whowechina/aic_pico/doc/aic_touch_pcb.png

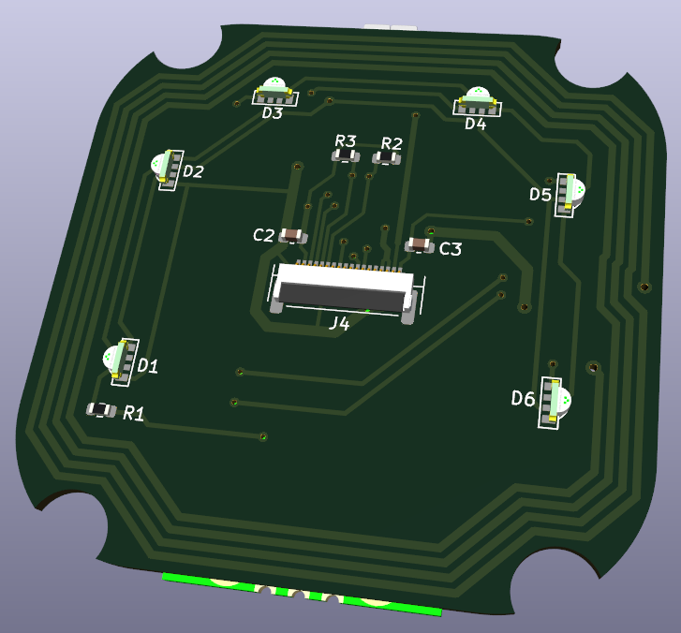
doc/aic_touch_pcb.png
