whowechina/aic_pico/res/aime_reader.png

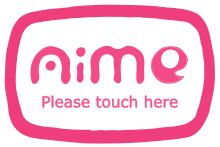
res/aime_reader.png
