whowechina/aic_pico/res/bana_reader.png

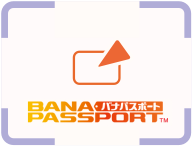
res/bana_reader.png
