whowechina/aic_pico/res/cards/aic_bana.png

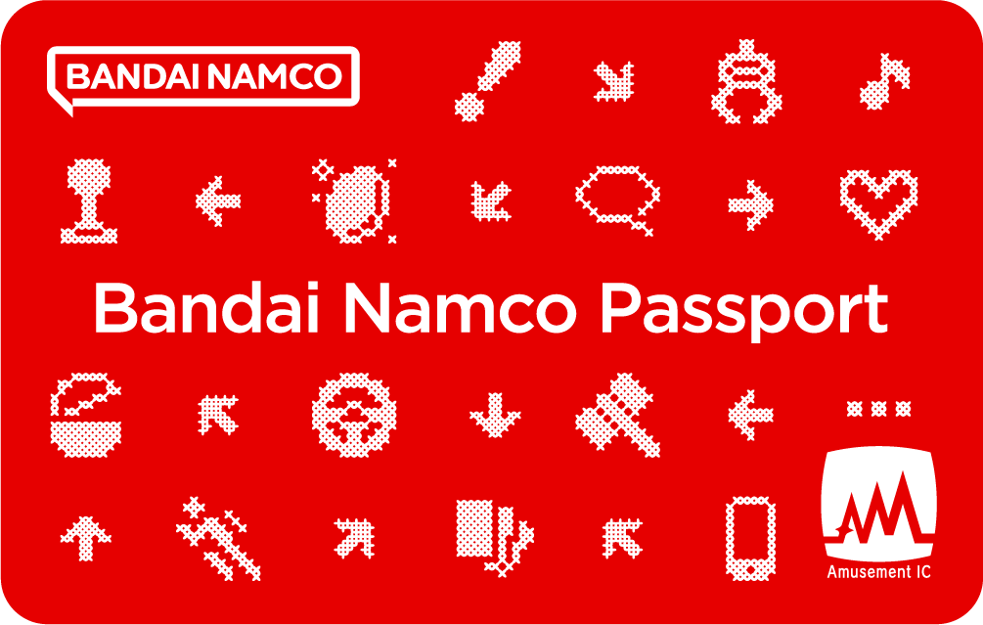
res/cards/aic_bana.png
