whowechina/aic_pico/res/cards/aic_bana_yellow.png

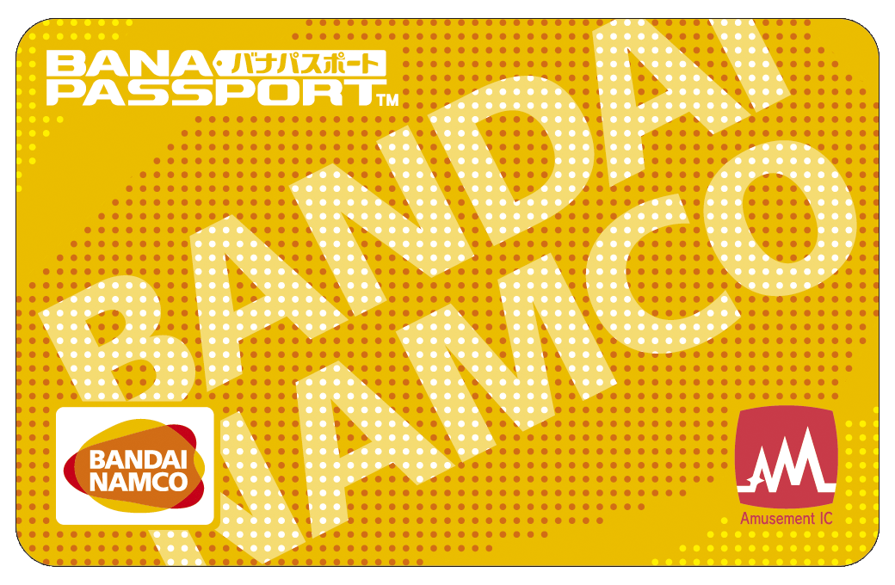
res/cards/aic_bana_yellow.png
