whowechina/aic_pico/res/cards/aic_generic.png

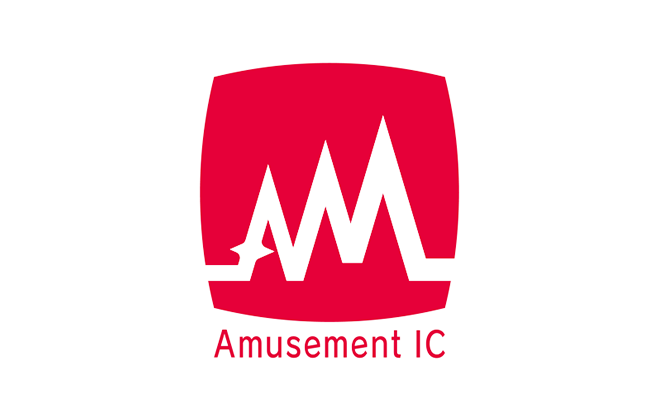
res/cards/aic_generic.png
