whowechina/aic_pico/res/cards/aic_generic_130.png

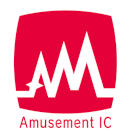
res/cards/aic_generic_130.png
