whowechina/aic_pico/res/cards/aic_konami.png

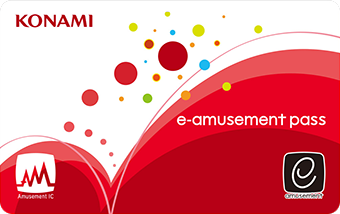
res/cards/aic_konami.png
