whowechina/aic_pico/res/cards/aic_nesica.png

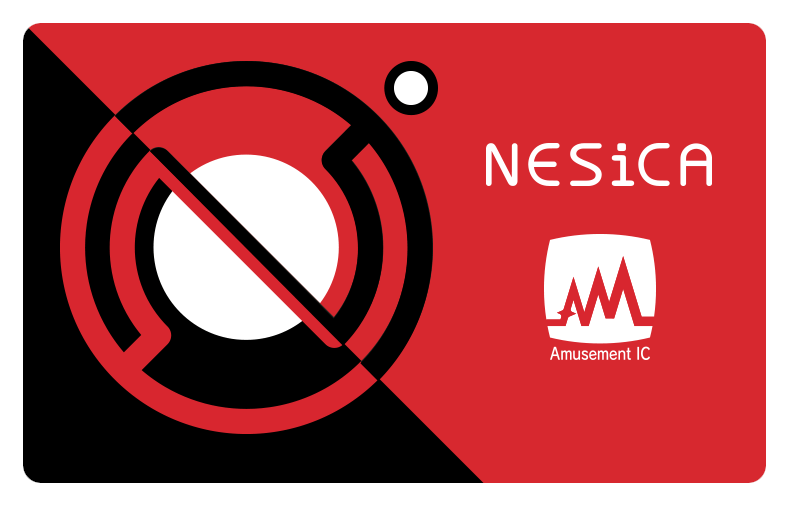
res/cards/aic_nesica.png
