whowechina/aic_pico/res/cards/aic_sega.png

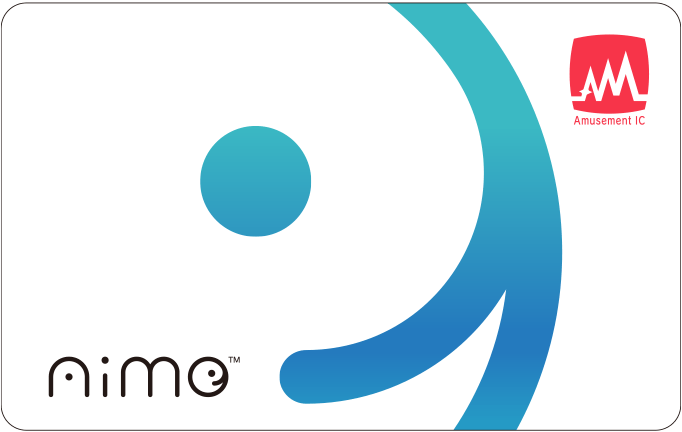
res/cards/aic_sega.png
