whowechina/aic_pico/res/cards/aic_sega_220.png

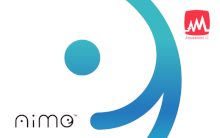
res/cards/aic_sega_220.png
