whowechina/aic_pico/res/cards/Aime20122018CardDesign.webp

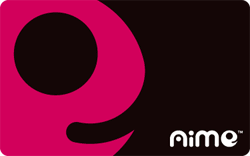
res/cards/Aime20122018CardDesign.webp
