whowechina/aic_pico/res/cards/bana_220.png

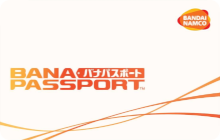
res/cards/bana_220.png
