whowechina/aic_pico/res/cards/bana_white.png

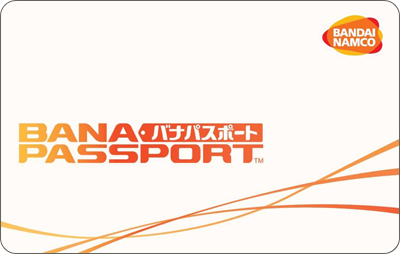
res/cards/bana_white.png
