whowechina/aic_pico/res/cards/eamuse.png

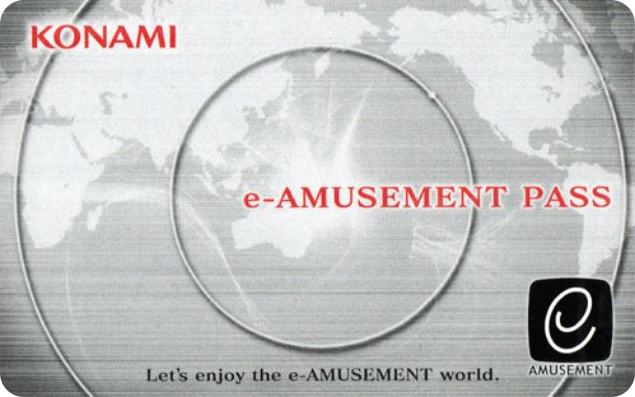
res/cards/eamuse.png
