whowechina/aic_pico/res/cards/nesica.png

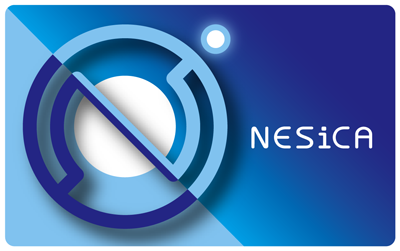
res/cards/nesica.png
