whowechina/aic_pico/res/cards/suica_220.png

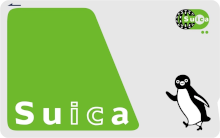
res/cards/suica_220.png
