whowechina/aic_pico/res/cards/vicinity_220.png

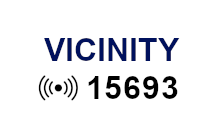
res/cards/vicinity_220.png
