whowechina/aic_pico/res/lightning.gif

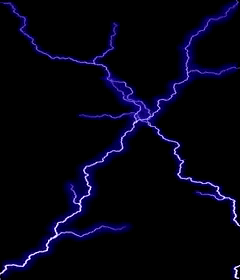
res/lightning.gif
