whowechina/aic_pico/Production/3DPrint/aic_touch_top_ams.3mf

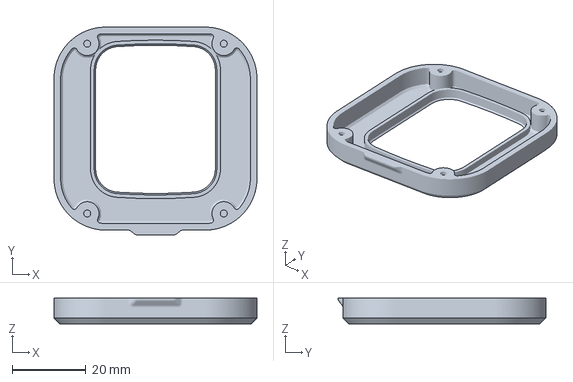
[picture p56: CAD file, 2024-10-22]
Production/3DPrint/aic_touch_top_ams.3mf
55.0 x 56.3 x 7.00 mm
