whowechina/aic_pico/Production/3DPrint/aic_touch_top.3mf

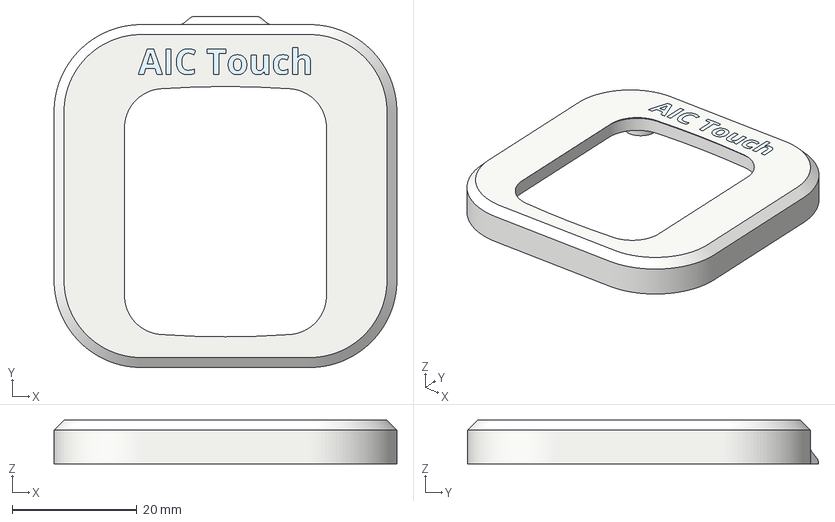
[picture p57: CAD file, 2024-06-03]
Production/3DPrint/aic_touch_top.3mf
55.0 x 56.3 x 7.00 mm
Top
Logo_A
Logo_I
Logo_C
Logo_T
Logo_o
Logo_u
Logo_c
Logo_h
