whowechina/aic_pico/Production/3DPrint/aic_key_top_nokey_ams.3mf

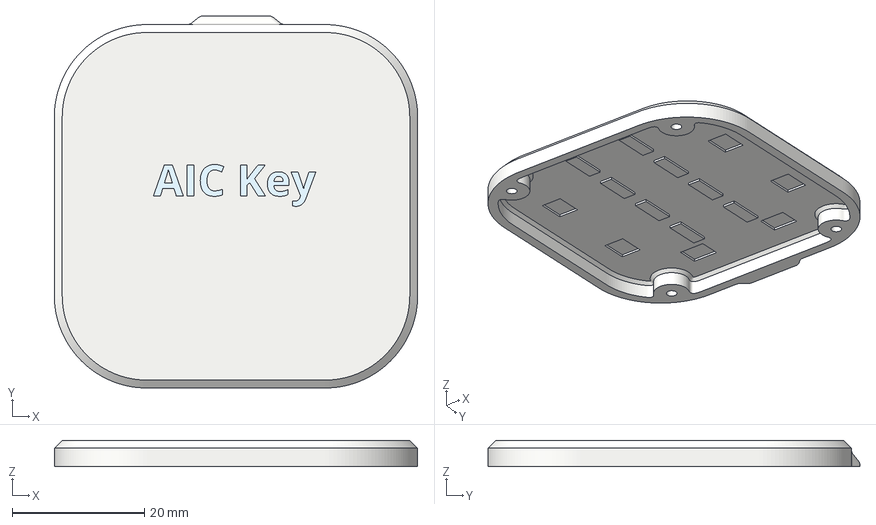
[picture p58: CAD file, 2024-03-24]
Production/3DPrint/aic_key_top_nokey_ams.3mf
55.0 x 56.3 x 4.00 mm
Logo_A
Top
Logo_I
Logo_C
Logo_K
Logo_e
Logo_y
