whowechina/aic_pico/Production/3DPrint/aic_key_top_nokey.stl

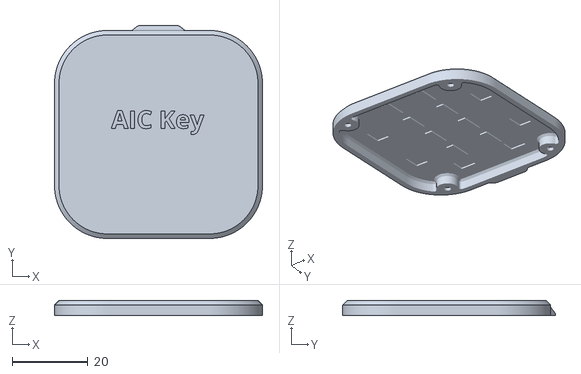
[picture p59: CAD file, 2024-03-24]
Production/3DPrint/aic_key_top_nokey.stl
55.0 x 56.3 x 4.00
