whowechina/aic_pico/Production/3DPrint/aic_key_top_surface_ams.3mf

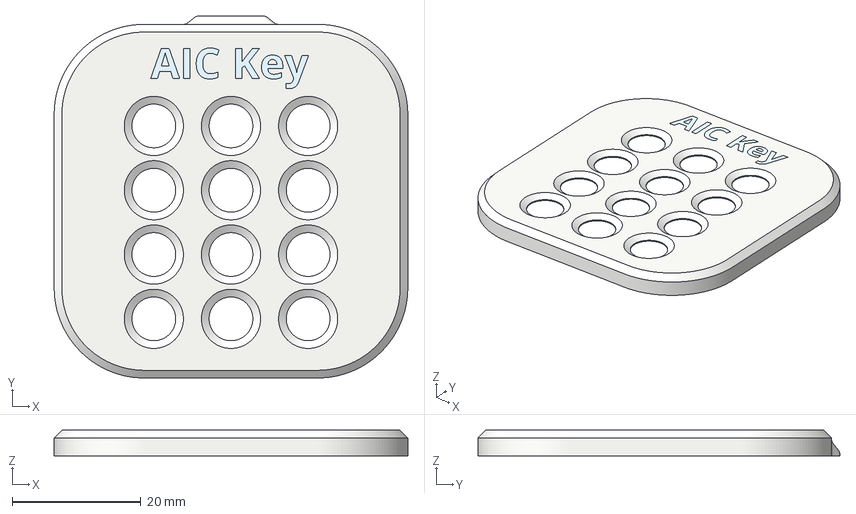
[picture p60: CAD file, 2024-02-25]
Production/3DPrint/aic_key_top_surface_ams.3mf
55.0 x 56.3 x 4.00 mm
Logo_K
Top
Logo_A
Logo_I
Logo_C
Logo_e
Logo_y
