whowechina/aic_pico/Production/3DPrint/aic_pico_top.stl.stl

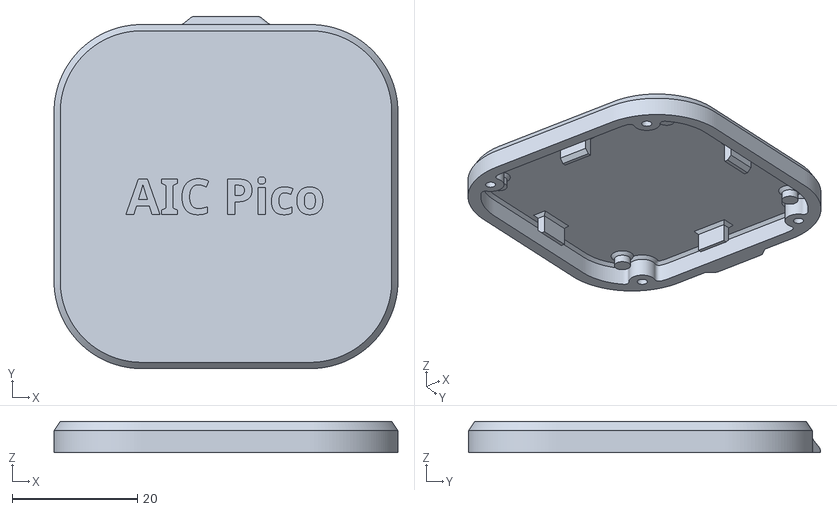
[picture p61: CAD file, 2024-02-25]
Production/3DPrint/aic_pico_top.stl.stl
55.0 x 56.3 x 5.00
