whowechina/aic_pico/Production/3DPrint/aic_pico_top_ams.3mf

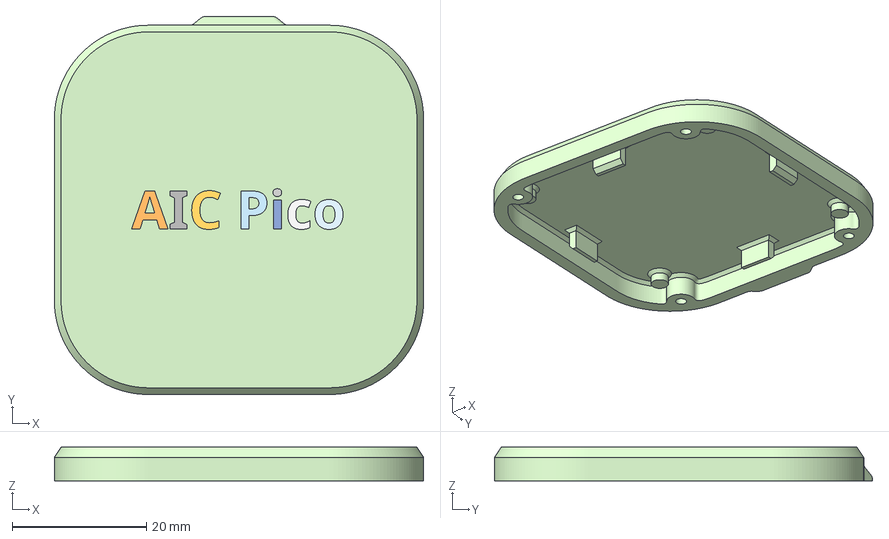
[picture p62: CAD file, 2024-02-25]
Production/3DPrint/aic_pico_top_ams.3mf
55.0 x 56.3 x 5.00 mm
Logo_2
Top
Logo_1
Logo_3
Logo_4
Logo_5
Logo_6
Logo_7
Logo_8
