whowechina/aic_pico/Production/3DPrint/aic_touch_bottom.stl

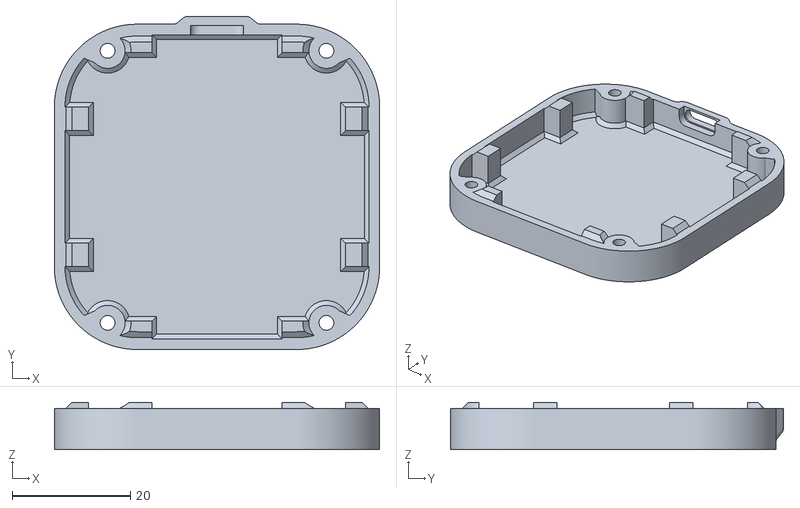
[picture p63: CAD file, 2024-02-25]
Production/3DPrint/aic_touch_bottom.stl
55.0 x 56.3 x 8.00
