whowechina/aic_pico/Production/3DPrint/aic_key_top_tact_ams.3mf

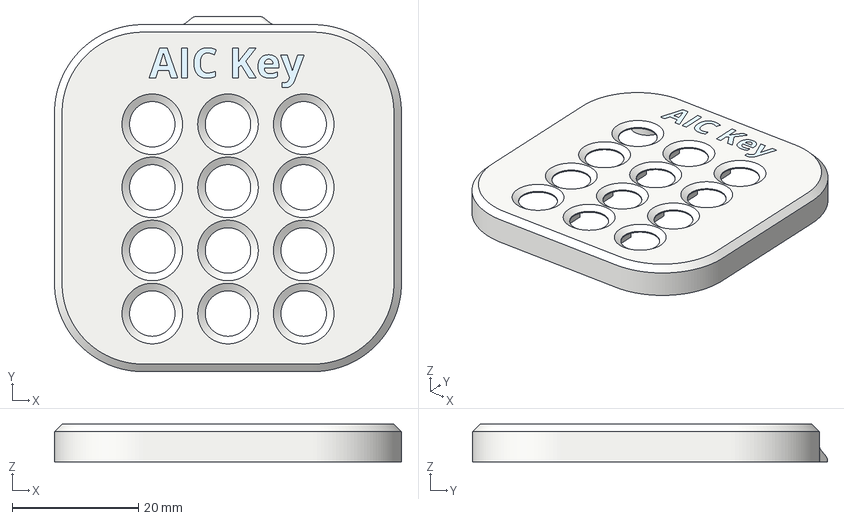
[picture p64: CAD file, 2024-02-25]
Production/3DPrint/aic_key_top_tact_ams.3mf
55.0 x 56.3 x 6.00 mm
Logo_y
Top
Logo_A
Logo_I
Logo_C
Logo_K
Logo_e
