whowechina/aic_pico/Production/3DPrint/aic_key_top_tact.stl

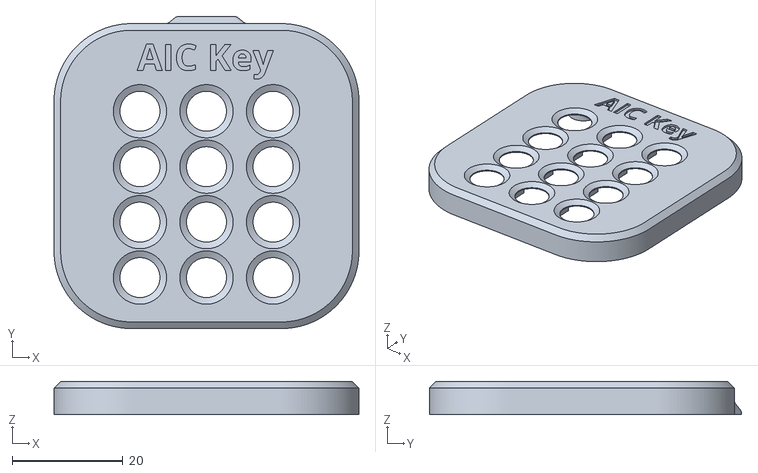
[picture p65: CAD file, 2024-02-25]
Production/3DPrint/aic_key_top_tact.stl
55.0 x 56.3 x 6.00
