whowechina/aic_pico/Production/3DPrint/aic_key_top_surface.stl

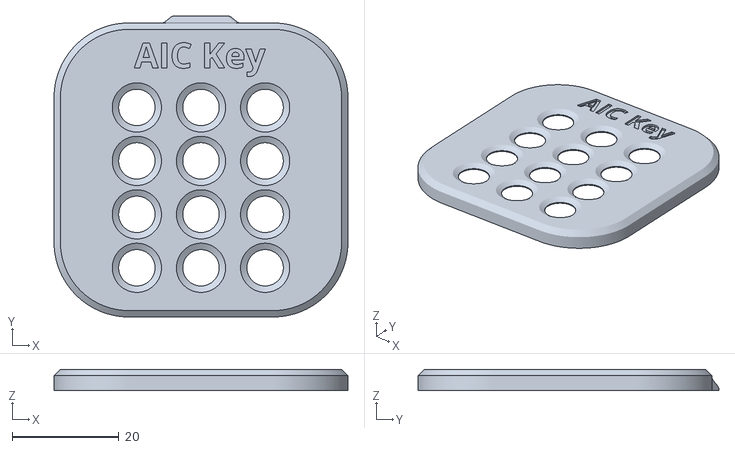
[picture p66: CAD file, 2024-02-25]
Production/3DPrint/aic_key_top_surface.stl
55.0 x 56.3 x 4.00
