whowechina/aic_pico/Production/3DPrint/aic_pico_top_tall.stl

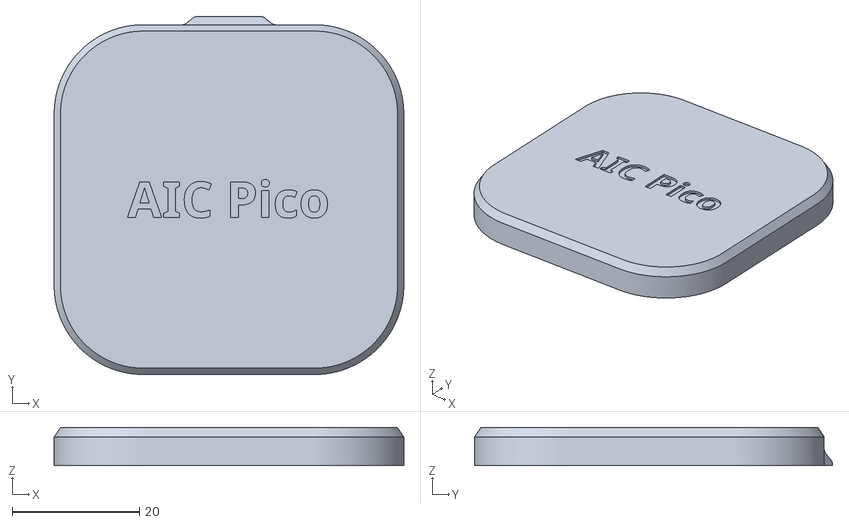
[picture p67: CAD file, 2024-02-25]
Production/3DPrint/aic_pico_top_tall.stl
55.0 x 56.3 x 6.00
