whowechina/aic_pico/Production/3DPrint/aic_pico_top_tall_ams.3mf

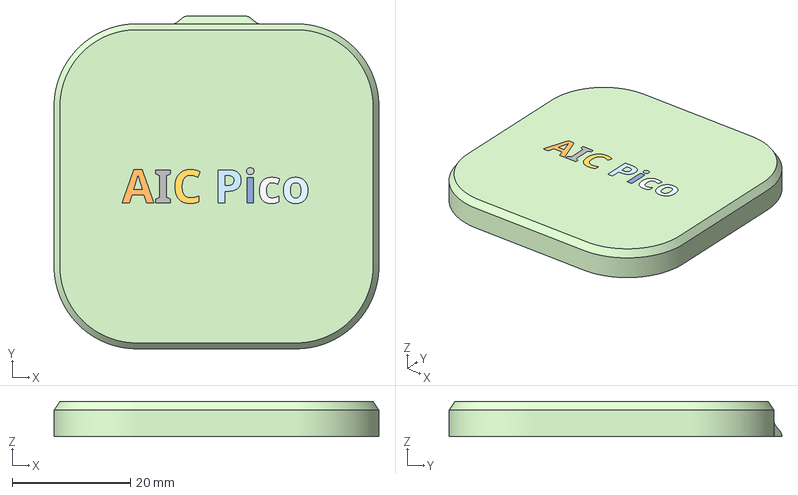
[picture p68: CAD file, 2024-02-25]
Production/3DPrint/aic_pico_top_tall_ams.3mf
55.0 x 56.3 x 6.00 mm
Logo_3
Top
Logo_1
Logo_2
Logo_4
Logo_5
Logo_6
Logo_7
Logo_8
