whowechina/aic_pico/Production/3DPrint/aic_pico_bottom.stl

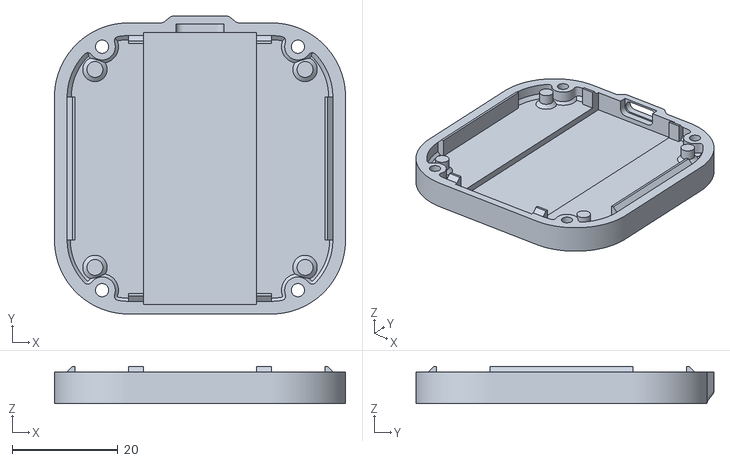
[picture p69: CAD file, 2024-02-25]
Production/3DPrint/aic_pico_bottom.stl
55.0 x 56.3 x 7.00
