whowechina/aic_pico/(list of files, cad)

Other CAD files:
Production/3DPrint/aic_touch_top.stl
