whowechina/aic_pico/(threads)

Thread 4 (2025-02-04):

AIC Pico Auto mode doesn't work on some games

Ragnar-es, 2025-02-04:
AIC Pico Auto mode doesn't work on some games like Sega World Drivers Championship and Fate Grand Order Arcade. Manually setting aime1 mode is needed everytime those games are played.

This is the debug output for SWDC on "Auto" mode, from when I launch the game until I get the 6506 error (which is aime reader error).

[auto_fail.txt](https://github.com/user-attachments/files/18659149/auto_fail.txt)

This is the debug output for SWDC on "Aime1" mode, from when I launch the game to when the reader gets lighted up ready to read cards.

[aime1_success.txt](https://github.com/user-attachments/files/18659150/aime1_success.txt)

whowechina, 2025-03-07:
So far, I have no way to tell the mode. I'll leave this open, until I find a solution or a complete dead-end.
