whowechina/aic_pico/(list of files, drawings)

Other design files:
doc/aic_pico_pn532.fzz
doc/aic_pico_pn5180.fzz
