whowechina/aic_pico/firmware/src/button_ani.h

#include "anima.h"

const uint8_t glow_data[] = {
    // frame 0
    0x00, 0x8d, 0x11, 0x10, 0x00, 0x03, 0x01, 0x00, 0x18, 0x11, 0x12, 0x22, 0x22, 0x11, 0x11, 0x12,
    0x22, 0x22, 0x11, 0x10, 0x00, 0x14, 0x11, 0x22, 0x33, 0x44, 0x44, 0x34, 0x55, 0x56, 0x67, 0x75,
    0x32, 0x21, 0x11, 0x00, 0x12, 0x01, 0x23, 0x67, 0x78, 0xaa, 0xda, 0x74, 0x22, 0x22, 0x22, 0x48,
    0xa6, 0x33, 0x21, 0x10, 0x00, 0x11, 0x14, 0x77, 0x77, 0xac, 0xda, 0x75, 0x31, 0x10, 0x11, 0x11,
    0x26, 0xba, 0xa6, 0x42, 0x21, 0x10, 0x00, 0x0f, 0x01, 0x55, 0x22, 0x23, 0x8a, 0x65, 0x42, 0x11,
    0x00, 0x01, 0x10, 0x01, 0x14, 0x8c, 0xda, 0x85, 0x32, 0x11, 0x00, 0x0e, 0x01, 0x26, 0x31, 0x11,
    0x12, 0x23, 0x32, 0x21, 0x00, 0x03, 0x01, 0x12, 0x35, 0x7c, 0xda, 0x84, 0x22, 0x11, 0x00, 0x0c,
    0x01, 0x12, 0x63, 0x10, 0x00, 0x01, 0x01, 0x12, 0x11, 0x00, 0x05, 0x12, 0x23, 0x35, 0x8d, 0xaa,
    0x53, 0x21, 0x10, 0x00, 0x0b, 0x12, 0x35, 0x51, 0x00, 0x02, 0x01, 0x11, 0x00, 0x07, 0x12, 0x33,
    0x47, 0xca, 0xa6, 0x32, 0x11, 0x00, 0x0a, 0x01, 0x26, 0xaa, 0x31, 0x00, 0x03, 0x01, 0x10, 0x00,
    0x06, 0x01, 0x22, 0x23, 0x6b, 0xbb, 0x63, 0x21, 0x10, 0x00, 0x09, 0x02, 0x67, 0x68, 0x32, 0x10,
    0x00, 0x02, 0x01, 0x10, 0x00, 0x07, 0x01, 0x22, 0x35, 0xbc, 0xc6, 0x32, 0x11, 0x00, 0x09, 0x14,
    0x53, 0x76, 0x22, 0x00, 0x0d, 0x12, 0x23, 0x6b, 0xda, 0x53, 0x21, 0x00, 0x09, 0x15, 0x22, 0x63,
    0x21, 0x00, 0x0d, 0x01, 0x22, 0x37, 0xcd, 0x84, 0x21, 0x10, 0x00, 0x07, 0x01, 0x25, 0x22, 0x11,
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
    0, 831, 1592, 2369, 3061, 3848, 4612, 5393, 6208, 7007, 7780, 8556, 9400, 10178, 10976, 11748, 12546, 13365, 14145, 14964, 15720,
};

const anima_t glow_ani = {
    .width = 64,
    .height = 64,
    .frames = 21,
    .index = glow_index,
    .data = glow_data,
};
