whowechina/aic_pico/firmware/src/conthrax.h

/*
 * Conthrax font by Typodermic Fonts Inc.
 * Downloaded from https://www.dafont.com/
 * Converted using https://lvgl.io/tools/fontconverter
 * Modificated for AIC Pico use
 */

#include <stdint.h>
#include "lvgl_font.h"

static const uint8_t conthrax_bitmap[] = {
    /* U+0030 "0" */
    0x0, 0x0, 0x0, 0x0, 0x15, 0x72, 0xad, 0xdb,
    0xed, 0xfb, 0xff, 0xff, 0xff, 0xff, 0xff, 0xff,
    0xff, 0xfb, 0xed, 0xdb, 0xae, 0x73, 0x16, 0x0,
    0x0, 0x0, 0x0, 0x0, 0x0, 0x1, 0x73, 0xf9,
    0xff, 0xff, 0xff, 0xff, 0xff, 0xff, 0xff, 0xff,
    0xff, 0xff, 0xff, 0xff, 0xff, 0xff, 0xff, 0xff,
    0xff, 0xf9, 0x77, 0x2, 0x0, 0x0, 0x0, 0x0,
    0x80, 0xff, 0xff, 0xff, 0xff, 0xff, 0xff, 0xff,
    0xff, 0xff, 0xff, 0xff, 0xff, 0xff, 0xff, 0xff,
    0xff, 0xff, 0xff, 0xff, 0xff, 0xff, 0x85, 0x0,
    0x0, 0x0, 0x29, 0xfd, 0xff, 0xff, 0xff, 0xff,
    0xff, 0xff, 0xff, 0xff, 0xff, 0xff, 0xff, 0xff,
    0xff, 0xff, 0xff, 0xff, 0xff, 0xff, 0xff, 0xff,
    0xff, 0xfe, 0x2e, 0x0, 0x0, 0x92, 0xff, 0xff,
    0xff, 0xff, 0xff, 0xbc, 0x7f, 0x64, 0x5b, 0x5b,
    0x5b, 0x5b, 0x5b, 0x5b, 0x5b, 0x64, 0x7f, 0xba,
    0xff, 0xff, 0xff, 0xff, 0xff, 0x98, 0x0, 0x0,
    0xd2, 0xff, 0xff, 0xff, 0xff, 0x6d, 0x0, 0x0,
    0x0, 0x0, 0x0, 0x0, 0x0, 0x0, 0x0, 0x0,
    0x0, 0x0, 0x0, 0x68, 0xff, 0xff, 0xff, 0xff,
    0xd8, 0x0, 0x5, 0xfc, 0xff, 0xff, 0xff, 0xe2,
    0x4, 0x0, 0x0, 0x0, 0x0, 0x0, 0x0, 0x0,
    0x0, 0x0, 0x0, 0x0, 0x0, 0x0, 0x2, 0xdd,
    0xff, 0xff, 0xff, 0xfe, 0xa, 0x14, 0xff, 0xff,
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
    0x93, 0xff, 0xff, 0xff, 0xff, 0xff, 0xff, 0x23,
    0x93, 0xff, 0xff, 0xff, 0xff, 0xff, 0xff, 0x23,
    0x93, 0xff, 0xff, 0xff, 0xff, 0xff, 0xff, 0x23,
    0x93, 0xff, 0xff, 0xff, 0xff, 0xff, 0xff, 0x23,
    0x93, 0xff, 0xff, 0xff, 0xff, 0xff, 0xff, 0x23
};

static const lv_font_dsc_t conthrax_dsc[] = {
    {.bitmap_index = 0, .adv_w = 464, .box_w = 27, .box_h = 23, .ofs_x = 1, .ofs_y = 0},
    {.bitmap_index = 621, .adv_w = 173, .box_w = 9, .box_h = 23, .ofs_x = 9, .ofs_y = 0},
    {.bitmap_index = 828, .adv_w = 442, .box_w = 25, .box_h = 23, .ofs_x = 1, .ofs_y = 0},
    {.bitmap_index = 1403, .adv_w = 432, .box_w = 25, .box_h = 23, .ofs_x = 1, .ofs_y = 0},
    {.bitmap_index = 1978, .adv_w = 463, .box_w = 28, .box_h = 23, .ofs_x = 1, .ofs_y = 0},
    {.bitmap_index = 2622, .adv_w = 442, .box_w = 25, .box_h = 23, .ofs_x = 1, .ofs_y = 0},
    {.bitmap_index = 3197, .adv_w = 444, .box_w = 25, .box_h = 23, .ofs_x = 1, .ofs_y = 0},
    {.bitmap_index = 3772, .adv_w = 424, .box_w = 26, .box_h = 23, .ofs_x = 0, .ofs_y = 0},
    {.bitmap_index = 4370, .adv_w = 463, .box_w = 27, .box_h = 23, .ofs_x = 1, .ofs_y = 0},
    {.bitmap_index = 4991, .adv_w = 444, .box_w = 25, .box_h = 23, .ofs_x = 1, .ofs_y = 0},
    {.bitmap_index = 5566, .adv_w = 286, .box_w = 32, .box_h = 23, .ofs_x = -2, .ofs_y = 0},
    {.bitmap_index = 6302, .adv_w = 217, .box_w = 8, .box_h = 7, .ofs_x = 8, .ofs_y = 6}
};

static const lv_font_t lv_conthrax = {
    .range_start = 48,
    .range_length = 12,
    .bit_per_pixel = 8,
    .line_height = 23,
    .base_line = 0,
    .dsc = conthrax_dsc,
    .bitmap = conthrax_bitmap,
};
