whowechina/aic_pico/firmware/src/ltsaeada.h

/*
 * LT Saeada font by LyonsType
 * Downloaded from https://www.dafont.com/
 * Converted using https://lvgl.io/tools/fontconverter
 * Modificated for AIC Pico use
 */

#include <stdint.h>
#include "lvgl_font.h"

static const uint8_t lts13_bitmap[] = {
    /* U+0020 " " */

    /* U+0021 "!" */
    0x4d, 0x7, 0xf2, 0x6f, 0x16, 0xf0, 0x5f, 0x4,
    0xf0, 0x3d, 0x3, 0xa0, 0x5e, 0x10,

    /* U+0022 "\"" */
    0x4c, 0x3d, 0x6, 0xe4, 0xf0, 0x6e, 0x4f, 0x1,
    0x30, 0x40,

    /* U+0023 "#" */
    0x0, 0x79, 0x8, 0x70, 0x0, 0xc7, 0xe, 0x50,
    0x3f, 0xff, 0xff, 0xf4, 0x5, 0xf4, 0x7f, 0x30,
    0x4, 0xf0, 0x6d, 0x0, 0xaf, 0xff, 0xff, 0xd0,
    0x1b, 0xb3, 0xc9, 0x20, 0xc, 0x70, 0xd5, 0x0,
    0xc, 0x30, 0xd2, 0x0,

    /* U+0024 "$" */
    0x0, 0x0, 0x0, 0x0, 0x0, 0x0, 0x80, 0x0,
    0x0, 0x2, 0x80, 0x0, 0x4, 0xcf, 0xe9, 0x20,
    0x2f, 0xca, 0xbd, 0xa0, 0x5f, 0x26, 0x40, 0x0,
    0x2f, 0xba, 0x30, 0x0, 0x3, 0xaf, 0xf9, 0x20,
    0x0, 0xa, 0x5d, 0xd0, 0x22, 0xb, 0x6, 0xf0,
    0x7f, 0xbd, 0x8e, 0xc0, 0x6, 0xcf, 0xea, 0x10,
    0x0, 0x19, 0x0, 0x0, 0x0, 0x2, 0x0, 0x0,

    /* U+0025 "%" */
    0x1b, 0xfb, 0x10, 0x6, 0xa0, 0x8, 0xa1, 0xa8,
    0x3, 0xf4, 0x0, 0x79, 0x9, 0x70, 0xd8, 0x0,
    0x1, 0xbe, 0xb0, 0xac, 0x0, 0x0, 0x0, 0x0,
    0x6f, 0x4c, 0xd6, 0x0, 0x0, 0x2f, 0x5b, 0x61,
    0xe1, 0x0, 0xd, 0xa0, 0xd1, 0xb, 0x40, 0x9,
    0xd0, 0xb, 0x73, 0xe2, 0x0, 0xe3, 0x0, 0x2d,
    0xe7, 0x0,

    /* U+0026 "&" */
    0x6, 0xdf, 0xe9, 0x10, 0x3f, 0xb6, 0x8c, 0x50,
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

    /* U+007D "}" */
    0x6f, 0xb1, 0x18, 0xf9, 0x0, 0xbc, 0x0, 0xac,
    0x0, 0xac, 0x0, 0xac, 0x0, 0xac, 0x0, 0xac,
    0x0, 0xac, 0x3, 0xea, 0x7f, 0xf4, 0x14, 0x10,

    /* U+007E "~" */
    0x0, 0x0, 0x0, 0x0, 0xa, 0xfc, 0x50, 0x95,
    0x6a, 0x16, 0xef, 0xc0, 0x0, 0x0, 0x1, 0x0
};

static const lv_font_dsc_t lts13_dsc[] = {
    {.bitmap_index = 0, .adv_w = 42, .box_w = 0, .box_h = 0, .ofs_x = 0, .ofs_y = 0},
    {.bitmap_index = 0, .adv_w = 43, .box_w = 3, .box_h = 9, .ofs_x = 0, .ofs_y = 0},
    {.bitmap_index = 14, .adv_w = 74, .box_w = 5, .box_h = 4, .ofs_x = 0, .ofs_y = 6},
    {.bitmap_index = 24, .adv_w = 123, .box_w = 8, .box_h = 9, .ofs_x = 0, .ofs_y = 0},
    {.bitmap_index = 60, .adv_w = 122, .box_w = 8, .box_h = 14, .ofs_x = 0, .ofs_y = -2},
    {.bitmap_index = 116, .adv_w = 171, .box_w = 11, .box_h = 9, .ofs_x = 0, .ofs_y = 0},
    {.bitmap_index = 166, .adv_w = 129, .box_w = 8, .box_h = 9, .ofs_x = 0, .ofs_y = 0},
    {.bitmap_index = 202, .adv_w = 40, .box_w = 2, .box_h = 4, .ofs_x = 0, .ofs_y = 6},
    {.bitmap_index = 206, .adv_w = 57, .box_w = 4, .box_h = 12, .ofs_x = 0, .ofs_y = -3},
    {.bitmap_index = 230, .adv_w = 57, .box_w = 5, .box_h = 12, .ofs_x = -1, .ofs_y = -3},
    {.bitmap_index = 260, .adv_w = 74, .box_w = 5, .box_h = 5, .ofs_x = 0, .ofs_y = 4},
    {.bitmap_index = 273, .adv_w = 105, .box_w = 7, .box_h = 7, .ofs_x = 0, .ofs_y = 2},
    {.bitmap_index = 298, .adv_w = 46, .box_w = 3, .box_h = 4, .ofs_x = 0, .ofs_y = -2},
    {.bitmap_index = 304, .adv_w = 85, .box_w = 5, .box_h = 3, .ofs_x = 0, .ofs_y = 2},
    {.bitmap_index = 312, .adv_w = 46, .box_w = 3, .box_h = 2, .ofs_x = 0, .ofs_y = 0},
    {.bitmap_index = 315, .adv_w = 87, .box_w = 6, .box_h = 12, .ofs_x = 0, .ofs_y = -3},
    {.bitmap_index = 351, .adv_w = 141, .box_w = 9, .box_h = 9, .ofs_x = 0, .ofs_y = 0},
    {.bitmap_index = 392, .adv_w = 63, .box_w = 4, .box_h = 9, .ofs_x = 0, .ofs_y = 0},
    {.bitmap_index = 410, .adv_w = 114, .box_w = 7, .box_h = 9, .ofs_x = 0, .ofs_y = 0},
    {.bitmap_index = 442, .adv_w = 114, .box_w = 7, .box_h = 9, .ofs_x = 0, .ofs_y = 0},
    {.bitmap_index = 474, .adv_w = 118, .box_w = 7, .box_h = 9, .ofs_x = 0, .ofs_y = 0},
    {.bitmap_index = 506, .adv_w = 117, .box_w = 7, .box_h = 9, .ofs_x = 0, .ofs_y = 0},
    {.bitmap_index = 538, .adv_w = 121, .box_w = 8, .box_h = 9, .ofs_x = 0, .ofs_y = 0},
    {.bitmap_index = 574, .adv_w = 115, .box_w = 7, .box_h = 9, .ofs_x = 0, .ofs_y = 0},
    {.bitmap_index = 606, .adv_w = 112, .box_w = 7, .box_h = 9, .ofs_x = 0, .ofs_y = 0},
    {.bitmap_index = 638, .adv_w = 122, .box_w = 8, .box_h = 9, .ofs_x = 0, .ofs_y = 0},
    {.bitmap_index = 674, .adv_w = 46, .box_w = 3, .box_h = 7, .ofs_x = 0, .ofs_y = 0},
    {.bitmap_index = 685, .adv_w = 46, .box_w = 3, .box_h = 9, .ofs_x = 0, .ofs_y = -2},
    {.bitmap_index = 699, .adv_w = 96, .box_w = 6, .box_h = 7, .ofs_x = 0, .ofs_y = 1},
    {.bitmap_index = 720, .adv_w = 105, .box_w = 7, .box_h = 5, .ofs_x = 0, .ofs_y = 2},
    {.bitmap_index = 738, .adv_w = 96, .box_w = 6, .box_h = 7, .ofs_x = 0, .ofs_y = 1},
    {.bitmap_index = 759, .adv_w = 103, .box_w = 7, .box_h = 9, .ofs_x = 0, .ofs_y = 0},
    {.bitmap_index = 791, .adv_w = 168, .box_w = 10, .box_h = 9, .ofs_x = 0, .ofs_y = 0},
    {.bitmap_index = 836, .adv_w = 155, .box_w = 10, .box_h = 9, .ofs_x = 0, .ofs_y = 0},
    {.bitmap_index = 881, .adv_w = 129, .box_w = 8, .box_h = 9, .ofs_x = 0, .ofs_y = 0},
    {.bitmap_index = 917, .adv_w = 142, .box_w = 9, .box_h = 9, .ofs_x = 0, .ofs_y = 0},
    {.bitmap_index = 958, .adv_w = 145, .box_w = 9, .box_h = 9, .ofs_x = 0, .ofs_y = 0},
    {.bitmap_index = 999, .adv_w = 118, .box_w = 7, .box_h = 9, .ofs_x = 0, .ofs_y = 0},
    {.bitmap_index = 1031, .adv_w = 118, .box_w = 7, .box_h = 9, .ofs_x = 0, .ofs_y = 0},
    {.bitmap_index = 1063, .adv_w = 159, .box_w = 10, .box_h = 9, .ofs_x = 0, .ofs_y = 0},
    {.bitmap_index = 1108, .adv_w = 142, .box_w = 9, .box_h = 9, .ofs_x = 0, .ofs_y = 0},
    {.bitmap_index = 1149, .adv_w = 46, .box_w = 3, .box_h = 9, .ofs_x = 0, .ofs_y = 0},
    {.bitmap_index = 1163, .adv_w = 108, .box_w = 7, .box_h = 9, .ofs_x = 0, .ofs_y = 0},
    {.bitmap_index = 1195, .adv_w = 125, .box_w = 8, .box_h = 9, .ofs_x = 0, .ofs_y = 0},
    {.bitmap_index = 1231, .adv_w = 118, .box_w = 7, .box_h = 9, .ofs_x = 0, .ofs_y = 0},
    {.bitmap_index = 1263, .adv_w = 167, .box_w = 11, .box_h = 9, .ofs_x = 0, .ofs_y = 0},
    {.bitmap_index = 1313, .adv_w = 142, .box_w = 9, .box_h = 9, .ofs_x = 0, .ofs_y = 0},
    {.bitmap_index = 1354, .adv_w = 167, .box_w = 10, .box_h = 9, .ofs_x = 0, .ofs_y = 0},
    {.bitmap_index = 1399, .adv_w = 126, .box_w = 8, .box_h = 9, .ofs_x = 0, .ofs_y = 0},
    {.bitmap_index = 1435, .adv_w = 167, .box_w = 10, .box_h = 12, .ofs_x = 0, .ofs_y = -3},
    {.bitmap_index = 1495, .adv_w = 127, .box_w = 8, .box_h = 9, .ofs_x = 0, .ofs_y = 0},
    {.bitmap_index = 1531, .adv_w = 121, .box_w = 8, .box_h = 9, .ofs_x = 0, .ofs_y = 0},
    {.bitmap_index = 1567, .adv_w = 123, .box_w = 8, .box_h = 9, .ofs_x = 0, .ofs_y = 0},
    {.bitmap_index = 1603, .adv_w = 141, .box_w = 9, .box_h = 9, .ofs_x = 0, .ofs_y = 0},
    {.bitmap_index = 1644, .adv_w = 147, .box_w = 9, .box_h = 9, .ofs_x = 0, .ofs_y = 0},
    {.bitmap_index = 1685, .adv_w = 190, .box_w = 12, .box_h = 9, .ofs_x = 0, .ofs_y = 0},
    {.bitmap_index = 1739, .adv_w = 125, .box_w = 8, .box_h = 9, .ofs_x = 0, .ofs_y = 0},
    {.bitmap_index = 1775, .adv_w = 125, .box_w = 8, .box_h = 9, .ofs_x = 0, .ofs_y = 0},
    {.bitmap_index = 1811, .adv_w = 122, .box_w = 8, .box_h = 9, .ofs_x = 0, .ofs_y = 0},
    {.bitmap_index = 1847, .adv_w = 72, .box_w = 5, .box_h = 12, .ofs_x = 0, .ofs_y = -3},
    {.bitmap_index = 1877, .adv_w = 87, .box_w = 6, .box_h = 12, .ofs_x = 0, .ofs_y = -3},
    {.bitmap_index = 1913, .adv_w = 72, .box_w = 4, .box_h = 12, .ofs_x = 0, .ofs_y = -3},
    {.bitmap_index = 1937, .adv_w = 121, .box_w = 8, .box_h = 6, .ofs_x = 0, .ofs_y = 4},
    {.bitmap_index = 1961, .adv_w = 83, .box_w = 7, .box_h = 3, .ofs_x = -1, .ofs_y = -3},
    {.bitmap_index = 1972, .adv_w = 52, .box_w = 3, .box_h = 3, .ofs_x = 0, .ofs_y = 7},
    {.bitmap_index = 1977, .adv_w = 128, .box_w = 8, .box_h = 7, .ofs_x = 0, .ofs_y = 0},
    {.bitmap_index = 2005, .adv_w = 128, .box_w = 8, .box_h = 10, .ofs_x = 0, .ofs_y = 0},
    {.bitmap_index = 2045, .adv_w = 103, .box_w = 7, .box_h = 7, .ofs_x = 0, .ofs_y = 0},
    {.bitmap_index = 2070, .adv_w = 128, .box_w = 8, .box_h = 10, .ofs_x = 0, .ofs_y = 0},
    {.bitmap_index = 2110, .adv_w = 119, .box_w = 7, .box_h = 7, .ofs_x = 0, .ofs_y = 0},
    {.bitmap_index = 2135, .adv_w = 87, .box_w = 6, .box_h = 9, .ofs_x = 0, .ofs_y = 0},
    {.bitmap_index = 2162, .adv_w = 128, .box_w = 8, .box_h = 10, .ofs_x = 0, .ofs_y = -3},
    {.bitmap_index = 2202, .adv_w = 116, .box_w = 7, .box_h = 10, .ofs_x = 0, .ofs_y = 0},
    {.bitmap_index = 2237, .adv_w = 46, .box_w = 3, .box_h = 10, .ofs_x = 0, .ofs_y = 0},
    {.bitmap_index = 2252, .adv_w = 48, .box_w = 4, .box_h = 13, .ofs_x = -1, .ofs_y = -3},
    {.bitmap_index = 2278, .adv_w = 103, .box_w = 7, .box_h = 10, .ofs_x = 0, .ofs_y = 0},
    {.bitmap_index = 2313, .adv_w = 41, .box_w = 2, .box_h = 10, .ofs_x = 0, .ofs_y = 0},
    {.bitmap_index = 2323, .adv_w = 174, .box_w = 11, .box_h = 7, .ofs_x = 0, .ofs_y = 0},
    {.bitmap_index = 2362, .adv_w = 116, .box_w = 7, .box_h = 7, .ofs_x = 0, .ofs_y = 0},
    {.bitmap_index = 2387, .adv_w = 127, .box_w = 8, .box_h = 7, .ofs_x = 0, .ofs_y = 0},
    {.bitmap_index = 2415, .adv_w = 128, .box_w = 8, .box_h = 10, .ofs_x = 0, .ofs_y = -3},
    {.bitmap_index = 2455, .adv_w = 128, .box_w = 8, .box_h = 10, .ofs_x = 0, .ofs_y = -3},
    {.bitmap_index = 2495, .adv_w = 78, .box_w = 5, .box_h = 7, .ofs_x = 0, .ofs_y = 0},
    {.bitmap_index = 2513, .adv_w = 88, .box_w = 6, .box_h = 7, .ofs_x = 0, .ofs_y = 0},
    {.bitmap_index = 2534, .adv_w = 71, .box_w = 5, .box_h = 9, .ofs_x = 0, .ofs_y = 0},
    {.bitmap_index = 2557, .adv_w = 117, .box_w = 7, .box_h = 7, .ofs_x = 0, .ofs_y = 0},
    {.bitmap_index = 2582, .adv_w = 109, .box_w = 7, .box_h = 7, .ofs_x = 0, .ofs_y = 0},
    {.bitmap_index = 2607, .adv_w = 174, .box_w = 11, .box_h = 7, .ofs_x = 0, .ofs_y = 0},
    {.bitmap_index = 2646, .adv_w = 105, .box_w = 7, .box_h = 7, .ofs_x = 0, .ofs_y = 0},
    {.bitmap_index = 2671, .adv_w = 109, .box_w = 7, .box_h = 10, .ofs_x = 0, .ofs_y = -3},
    {.bitmap_index = 2706, .adv_w = 104, .box_w = 7, .box_h = 7, .ofs_x = 0, .ofs_y = 0},
    {.bitmap_index = 2731, .adv_w = 72, .box_w = 5, .box_h = 12, .ofs_x = 0, .ofs_y = -3},
    {.bitmap_index = 2761, .adv_w = 41, .box_w = 2, .box_h = 12, .ofs_x = 0, .ofs_y = -3},
    {.bitmap_index = 2773, .adv_w = 72, .box_w = 4, .box_h = 12, .ofs_x = 0, .ofs_y = -3},
    {.bitmap_index = 2797, .adv_w = 128, .box_w = 8, .box_h = 4, .ofs_x = 0, .ofs_y = 3}
};

static const uint8_t lts14_bitmap[] = {
    /* U+0020 " " */

    /* U+0021 "!" */
    0x4e, 0x26, 0xf4, 0x6f, 0x45, 0xf3, 0x4f, 0x23,
    0xf1, 0x2f, 0x2, 0xb1, 0x4e, 0x20,

    /* U+0022 "\"" */
    0x3d, 0x1e, 0x35, 0xf2, 0xf5, 0x5f, 0x2f, 0x51,
    0x40, 0x41,

    /* U+0023 "#" */
    0x0, 0x4c, 0x3, 0xe0, 0x0, 0x9b, 0x8, 0xd0,
    0x2f, 0xff, 0xff, 0xfd, 0x3, 0xf7, 0x3e, 0x82,
    0x2, 0xf3, 0xf, 0x40, 0x9f, 0xff, 0xff, 0xf6,
    0x19, 0xd3, 0x8e, 0x30, 0xa, 0xa0, 0x8c, 0x0,
    0xa, 0x60, 0x98, 0x0,

    /* U+0024 "$" */
    0x0, 0x0, 0x0, 0x0, 0x0, 0x0, 0xa0, 0x0,
    0x0, 0x0, 0xb0, 0x0, 0x3, 0xbe, 0xfb, 0x50,
    0x1f, 0xe8, 0xdb, 0xf2, 0x4f, 0x52, 0x90, 0x0,
    0x1f, 0xd8, 0x80, 0x0, 0x3, 0x9f, 0xfc, 0x60,
    0x0, 0x7, 0x79, 0xf6, 0x23, 0x9, 0x20, 0xf9,
    0x6f, 0xcd, 0x8c, 0xf4, 0x5, 0xbf, 0xfc, 0x50,
    0x0, 0xc, 0x0, 0x0, 0x0, 0x3, 0x0, 0x0,

    /* U+0025 "%" */
    0xa, 0xfd, 0x30, 0x0, 0xc5, 0x0, 0x7b, 0x16,
    0xd0, 0xa, 0xd0, 0x0, 0x7a, 0x5, 0xd0, 0x7f,
    0x20, 0x0, 0xa, 0xec, 0x33, 0xf5, 0x0, 0x0,
    0x0, 0x0, 0x1e, 0x87, 0xec, 0x30, 0x0, 0x0,
    0xcb, 0x3e, 0x25, 0xd0, 0x0, 0x9, 0xe1, 0x6a,
    0x0, 0xf1, 0x0, 0x6f, 0x30, 0x3e, 0x36, 0xe0,
    0x0, 0xc6, 0x0, 0x8, 0xed, 0x40,

    /* U+0026 "&" */
    0x5, 0xcf, 0xec, 0x40, 0x2, 0xfc, 0x77, 0xac,
    0x0, 0x2f, 0x82, 0x0, 0x0, 0x0, 0x3f, 0xff,
    0xff, 0xf3, 0x1e, 0xc6, 0x35, 0xf8, 0x7, 0xf1,
    0x0, 0x1f, 0x60, 0x7f, 0x10, 0x2, 0xf6, 0x2,
    0xfd, 0x77, 0xcf, 0x30, 0x3, 0xbe, 0xeb, 0x30,
    0x0,

    /* U+0027 "'" */
    0x3d, 0x5, 0xf0, 0x5f, 0x1, 0x40,

    /* U+0028 "(" */
    0x0, 0xa7, 0x5, 0xf4, 0xd, 0xc0, 0x2f, 0x60,
    0x5f, 0x30, 0x7f, 0x0, 0x8f, 0x0, 0x5f, 0x30,
    0x2f, 0x60, 0xd, 0xc0, 0x5, 0xf4, 0x0, 0xa7,

    /* U+0029 ")" */
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
    0x5, 0xdf, 0x31, 0xfd, 0x70, 0x3f, 0x60, 0x3,
    0xf5, 0x0, 0x3f, 0x50, 0x3, 0xf5, 0x0, 0x3f,
    0x50, 0x3, 0xf5, 0x0, 0x3f, 0x50, 0x2, 0xfa,
    0x20, 0xa, 0xff, 0x40, 0x2, 0x40,

    /* U+007C "|" */
    0x2d, 0x3f, 0x3f, 0x3f, 0x3f, 0x3f, 0x3f, 0x3f,
    0x3f, 0x3f, 0x3f, 0x1a,

    /* U+007D "}" */
    0x6f, 0xd4, 0x1, 0x7e, 0xe0, 0x0, 0x8f, 0x0,
    0x7, 0xf0, 0x0, 0x7f, 0x0, 0x7, 0xf0, 0x0,
    0x7f, 0x0, 0x7, 0xf0, 0x0, 0x7f, 0x0, 0x2c,
    0xf0, 0x6f, 0xf7, 0x0, 0x42, 0x0,

    /* U+007E "~" */
    0x9, 0xed, 0x71, 0x3d, 0x5, 0xc1, 0x4c, 0xff,
    0x60, 0x0, 0x0, 0x1, 0x0, 0x0
};

static const lv_font_dsc_t lts14_dsc[] = {
    {.bitmap_index = 0, .adv_w = 45, .box_w = 0, .box_h = 0, .ofs_x = 0, .ofs_y = 0},
    {.bitmap_index = 0, .adv_w = 46, .box_w = 3, .box_h = 9, .ofs_x = 0, .ofs_y = 0},
    {.bitmap_index = 14, .adv_w = 80, .box_w = 5, .box_h = 4, .ofs_x = 0, .ofs_y = 6},
    {.bitmap_index = 24, .adv_w = 132, .box_w = 8, .box_h = 9, .ofs_x = 0, .ofs_y = 0},
    {.bitmap_index = 60, .adv_w = 131, .box_w = 8, .box_h = 14, .ofs_x = 0, .ofs_y = -2},
    {.bitmap_index = 116, .adv_w = 184, .box_w = 12, .box_h = 9, .ofs_x = 0, .ofs_y = 0},
    {.bitmap_index = 170, .adv_w = 139, .box_w = 9, .box_h = 9, .ofs_x = 0, .ofs_y = 0},
    {.bitmap_index = 211, .adv_w = 43, .box_w = 3, .box_h = 4, .ofs_x = 0, .ofs_y = 6},
    {.bitmap_index = 217, .adv_w = 61, .box_w = 4, .box_h = 12, .ofs_x = 0, .ofs_y = -3},
    {.bitmap_index = 241, .adv_w = 61, .box_w = 5, .box_h = 12, .ofs_x = -1, .ofs_y = -3},
    {.bitmap_index = 271, .adv_w = 80, .box_w = 5, .box_h = 5, .ofs_x = 0, .ofs_y = 4},
    {.bitmap_index = 284, .adv_w = 113, .box_w = 7, .box_h = 7, .ofs_x = 0, .ofs_y = 2},
    {.bitmap_index = 309, .adv_w = 50, .box_w = 3, .box_h = 4, .ofs_x = 0, .ofs_y = -2},
    {.bitmap_index = 315, .adv_w = 92, .box_w = 6, .box_h = 3, .ofs_x = 0, .ofs_y = 2},
    {.bitmap_index = 324, .adv_w = 50, .box_w = 3, .box_h = 2, .ofs_x = 0, .ofs_y = 0},
    {.bitmap_index = 327, .adv_w = 94, .box_w = 6, .box_h = 12, .ofs_x = 0, .ofs_y = -3},
    {.bitmap_index = 363, .adv_w = 152, .box_w = 9, .box_h = 9, .ofs_x = 0, .ofs_y = 0},
    {.bitmap_index = 404, .adv_w = 68, .box_w = 4, .box_h = 9, .ofs_x = 0, .ofs_y = 0},
    {.bitmap_index = 422, .adv_w = 123, .box_w = 8, .box_h = 9, .ofs_x = 0, .ofs_y = 0},
    {.bitmap_index = 458, .adv_w = 123, .box_w = 8, .box_h = 9, .ofs_x = 0, .ofs_y = 0},
    {.bitmap_index = 494, .adv_w = 127, .box_w = 8, .box_h = 9, .ofs_x = 0, .ofs_y = 0},
    {.bitmap_index = 530, .adv_w = 126, .box_w = 8, .box_h = 9, .ofs_x = 0, .ofs_y = 0},
    {.bitmap_index = 566, .adv_w = 131, .box_w = 8, .box_h = 9, .ofs_x = 0, .ofs_y = 0},
    {.bitmap_index = 602, .adv_w = 124, .box_w = 8, .box_h = 9, .ofs_x = 0, .ofs_y = 0},
    {.bitmap_index = 638, .adv_w = 120, .box_w = 8, .box_h = 9, .ofs_x = 0, .ofs_y = 0},
    {.bitmap_index = 674, .adv_w = 131, .box_w = 8, .box_h = 9, .ofs_x = 0, .ofs_y = 0},
    {.bitmap_index = 710, .adv_w = 50, .box_w = 3, .box_h = 7, .ofs_x = 0, .ofs_y = 0},
    {.bitmap_index = 721, .adv_w = 50, .box_w = 3, .box_h = 9, .ofs_x = 0, .ofs_y = -2},
    {.bitmap_index = 735, .adv_w = 103, .box_w = 7, .box_h = 7, .ofs_x = 0, .ofs_y = 1},
    {.bitmap_index = 760, .adv_w = 113, .box_w = 7, .box_h = 5, .ofs_x = 0, .ofs_y = 2},
    {.bitmap_index = 778, .adv_w = 103, .box_w = 7, .box_h = 7, .ofs_x = 0, .ofs_y = 1},
    {.bitmap_index = 803, .adv_w = 111, .box_w = 7, .box_h = 9, .ofs_x = 0, .ofs_y = 0},
    {.bitmap_index = 835, .adv_w = 181, .box_w = 11, .box_h = 9, .ofs_x = 0, .ofs_y = 0},
    {.bitmap_index = 885, .adv_w = 167, .box_w = 11, .box_h = 9, .ofs_x = 0, .ofs_y = 0},
    {.bitmap_index = 935, .adv_w = 139, .box_w = 9, .box_h = 9, .ofs_x = 0, .ofs_y = 0},
    {.bitmap_index = 976, .adv_w = 153, .box_w = 10, .box_h = 9, .ofs_x = 0, .ofs_y = 0},
    {.bitmap_index = 1021, .adv_w = 156, .box_w = 10, .box_h = 9, .ofs_x = 0, .ofs_y = 0},
    {.bitmap_index = 1066, .adv_w = 127, .box_w = 8, .box_h = 9, .ofs_x = 0, .ofs_y = 0},
    {.bitmap_index = 1102, .adv_w = 127, .box_w = 8, .box_h = 9, .ofs_x = 0, .ofs_y = 0},
    {.bitmap_index = 1138, .adv_w = 171, .box_w = 11, .box_h = 9, .ofs_x = 0, .ofs_y = 0},
    {.bitmap_index = 1188, .adv_w = 153, .box_w = 9, .box_h = 9, .ofs_x = 0, .ofs_y = 0},
    {.bitmap_index = 1229, .adv_w = 50, .box_w = 3, .box_h = 9, .ofs_x = 0, .ofs_y = 0},
    {.bitmap_index = 1243, .adv_w = 116, .box_w = 7, .box_h = 9, .ofs_x = 0, .ofs_y = 0},
    {.bitmap_index = 1275, .adv_w = 134, .box_w = 9, .box_h = 9, .ofs_x = 0, .ofs_y = 0},
    {.bitmap_index = 1316, .adv_w = 127, .box_w = 8, .box_h = 9, .ofs_x = 0, .ofs_y = 0},
    {.bitmap_index = 1352, .adv_w = 180, .box_w = 11, .box_h = 9, .ofs_x = 0, .ofs_y = 0},
    {.bitmap_index = 1402, .adv_w = 153, .box_w = 9, .box_h = 9, .ofs_x = 0, .ofs_y = 0},
    {.bitmap_index = 1443, .adv_w = 179, .box_w = 11, .box_h = 9, .ofs_x = 0, .ofs_y = 0},
    {.bitmap_index = 1493, .adv_w = 136, .box_w = 9, .box_h = 9, .ofs_x = 0, .ofs_y = 0},
    {.bitmap_index = 1534, .adv_w = 179, .box_w = 11, .box_h = 12, .ofs_x = 0, .ofs_y = -3},
    {.bitmap_index = 1600, .adv_w = 136, .box_w = 9, .box_h = 9, .ofs_x = 0, .ofs_y = 0},
    {.bitmap_index = 1641, .adv_w = 130, .box_w = 8, .box_h = 9, .ofs_x = 0, .ofs_y = 0},
    {.bitmap_index = 1677, .adv_w = 132, .box_w = 8, .box_h = 9, .ofs_x = 0, .ofs_y = 0},
    {.bitmap_index = 1713, .adv_w = 152, .box_w = 9, .box_h = 9, .ofs_x = 0, .ofs_y = 0},
    {.bitmap_index = 1754, .adv_w = 158, .box_w = 10, .box_h = 9, .ofs_x = 0, .ofs_y = 0},
    {.bitmap_index = 1799, .adv_w = 204, .box_w = 13, .box_h = 9, .ofs_x = 0, .ofs_y = 0},
    {.bitmap_index = 1858, .adv_w = 135, .box_w = 9, .box_h = 9, .ofs_x = 0, .ofs_y = 0},
    {.bitmap_index = 1899, .adv_w = 135, .box_w = 9, .box_h = 9, .ofs_x = 0, .ofs_y = 0},
    {.bitmap_index = 1940, .adv_w = 131, .box_w = 8, .box_h = 9, .ofs_x = 0, .ofs_y = 0},
    {.bitmap_index = 1976, .adv_w = 78, .box_w = 5, .box_h = 12, .ofs_x = 0, .ofs_y = -3},
    {.bitmap_index = 2006, .adv_w = 94, .box_w = 6, .box_h = 12, .ofs_x = 0, .ofs_y = -3},
    {.bitmap_index = 2042, .adv_w = 78, .box_w = 5, .box_h = 12, .ofs_x = 0, .ofs_y = -3},
    {.bitmap_index = 2072, .adv_w = 130, .box_w = 8, .box_h = 6, .ofs_x = 0, .ofs_y = 4},
    {.bitmap_index = 2096, .adv_w = 89, .box_w = 8, .box_h = 3, .ofs_x = -1, .ofs_y = -3},
    {.bitmap_index = 2108, .adv_w = 56, .box_w = 4, .box_h = 3, .ofs_x = 0, .ofs_y = 7},
    {.bitmap_index = 2114, .adv_w = 138, .box_w = 8, .box_h = 7, .ofs_x = 0, .ofs_y = 0},
    {.bitmap_index = 2142, .adv_w = 137, .box_w = 9, .box_h = 10, .ofs_x = 0, .ofs_y = 0},
    {.bitmap_index = 2187, .adv_w = 111, .box_w = 7, .box_h = 7, .ofs_x = 0, .ofs_y = 0},
    {.bitmap_index = 2212, .adv_w = 137, .box_w = 8, .box_h = 10, .ofs_x = 0, .ofs_y = 0},
    {.bitmap_index = 2252, .adv_w = 128, .box_w = 8, .box_h = 7, .ofs_x = 0, .ofs_y = 0},
    {.bitmap_index = 2280, .adv_w = 93, .box_w = 6, .box_h = 9, .ofs_x = 0, .ofs_y = 0},
    {.bitmap_index = 2307, .adv_w = 138, .box_w = 8, .box_h = 10, .ofs_x = 0, .ofs_y = -3},
    {.bitmap_index = 2347, .adv_w = 125, .box_w = 8, .box_h = 10, .ofs_x = 0, .ofs_y = 0},
    {.bitmap_index = 2387, .adv_w = 49, .box_w = 3, .box_h = 10, .ofs_x = 0, .ofs_y = 0},
    {.bitmap_index = 2402, .adv_w = 52, .box_w = 4, .box_h = 13, .ofs_x = -1, .ofs_y = -3},
    {.bitmap_index = 2428, .adv_w = 111, .box_w = 7, .box_h = 10, .ofs_x = 0, .ofs_y = 0},
    {.bitmap_index = 2463, .adv_w = 44, .box_w = 3, .box_h = 10, .ofs_x = 0, .ofs_y = 0},
    {.bitmap_index = 2478, .adv_w = 187, .box_w = 12, .box_h = 7, .ofs_x = 0, .ofs_y = 0},
    {.bitmap_index = 2520, .adv_w = 125, .box_w = 8, .box_h = 7, .ofs_x = 0, .ofs_y = 0},
    {.bitmap_index = 2548, .adv_w = 136, .box_w = 8, .box_h = 7, .ofs_x = 0, .ofs_y = 0},
    {.bitmap_index = 2576, .adv_w = 137, .box_w = 9, .box_h = 10, .ofs_x = 0, .ofs_y = -3},
    {.bitmap_index = 2621, .adv_w = 137, .box_w = 8, .box_h = 10, .ofs_x = 0, .ofs_y = -3},
    {.bitmap_index = 2661, .adv_w = 84, .box_w = 6, .box_h = 7, .ofs_x = 0, .ofs_y = 0},
    {.bitmap_index = 2682, .adv_w = 95, .box_w = 6, .box_h = 7, .ofs_x = 0, .ofs_y = 0},
    {.bitmap_index = 2703, .adv_w = 76, .box_w = 5, .box_h = 9, .ofs_x = 0, .ofs_y = 0},
    {.bitmap_index = 2726, .adv_w = 126, .box_w = 8, .box_h = 7, .ofs_x = 0, .ofs_y = 0},
    {.bitmap_index = 2754, .adv_w = 118, .box_w = 8, .box_h = 7, .ofs_x = 0, .ofs_y = 0},
    {.bitmap_index = 2782, .adv_w = 187, .box_w = 12, .box_h = 7, .ofs_x = 0, .ofs_y = 0},
    {.bitmap_index = 2824, .adv_w = 113, .box_w = 7, .box_h = 7, .ofs_x = 0, .ofs_y = 0},
    {.bitmap_index = 2849, .adv_w = 118, .box_w = 8, .box_h = 10, .ofs_x = 0, .ofs_y = -3},
    {.bitmap_index = 2889, .adv_w = 112, .box_w = 7, .box_h = 7, .ofs_x = 0, .ofs_y = 0},
    {.bitmap_index = 2914, .adv_w = 78, .box_w = 5, .box_h = 12, .ofs_x = 0, .ofs_y = -3},
    {.bitmap_index = 2944, .adv_w = 44, .box_w = 2, .box_h = 12, .ofs_x = 0, .ofs_y = -3},
    {.bitmap_index = 2956, .adv_w = 78, .box_w = 5, .box_h = 12, .ofs_x = 0, .ofs_y = -3},
    {.bitmap_index = 2986, .adv_w = 138, .box_w = 9, .box_h = 3, .ofs_x = 0, .ofs_y = 3}
};

static const uint8_t lts16_bitmap[] = {
    /* U+0020 " " */

    /* U+0021 "!" */
    0x2e, 0x65, 0xfa, 0x5f, 0x94, 0xf8, 0x3f, 0x72,
    0xf6, 0x1f, 0x50, 0xf3, 0x0, 0x3, 0xe6, 0x2e,
    0x60,

    /* U+0022 "\"" */
    0x2e, 0x37, 0xc4, 0xf5, 0xae, 0x4f, 0x5a, 0xe2,
    0xb3, 0x7a,

    /* U+0023 "#" */
    0x0, 0xd, 0x50, 0x4e, 0x0, 0x0, 0x1f, 0x60,
    0x9e, 0x0, 0x0, 0x4f, 0x30, 0xcb, 0x0, 0xe,
    0xff, 0xff, 0xff, 0xe0, 0x5, 0xde, 0x67, 0xf9,
    0x50, 0x0, 0xcb, 0x3, 0xf4, 0x0, 0x1, 0xea,
    0x16, 0xf3, 0x0, 0x9f, 0xff, 0xff, 0xff, 0x70,
    0x17, 0xf7, 0x4c, 0xd4, 0x10, 0x7, 0xf0, 0xe,
    0x90, 0x0, 0x7, 0xb0, 0xe, 0x50, 0x0,

    /* U+0024 "$" */
    0x0, 0x0, 0x0, 0x0, 0x0, 0x0, 0x2, 0x90,
    0x0, 0x0, 0x0, 0x39, 0x0, 0x0, 0x7, 0xdf,
    0xfb, 0x40, 0xb, 0xfd, 0xcd, 0xff, 0x32, 0xfb,
    0x8, 0x51, 0x60, 0x2f, 0xa0, 0xa3, 0x0, 0x0,
    0xcf, 0xcd, 0x30, 0x0, 0x1, 0x7d, 0xff, 0xc5,
    0x0, 0x0, 0xe, 0x8e, 0xf5, 0x0, 0x0, 0xd0,
    0x2f, 0xa5, 0xb4, 0x2b, 0x5, 0xf9, 0x3f, 0xfe,
    0xdc, 0xff, 0x20, 0x19, 0xef, 0xea, 0x20, 0x0,
    0x6, 0x60, 0x0, 0x0, 0x0, 0x21, 0x0, 0x0,

    /* U+0025 "%" */
    0x7, 0xee, 0x80, 0x0, 0x9, 0xa0, 0x4, 0xf6,
    0x5e, 0x60, 0x5, 0xf7, 0x0, 0x7b, 0x0, 0x99,
    0x2, 0xfb, 0x0, 0x4, 0xe2, 0x1d, 0x70, 0xce,
    0x10, 0x0, 0x9, 0xff, 0xa0, 0x9f, 0x30, 0x0,
    0x0, 0x0, 0x0, 0x4f, 0x70, 0x0, 0x0, 0x0,
    0x0, 0x1e, 0xb0, 0x6d, 0xd8, 0x0, 0x0, 0xc,
    0xe1, 0x3f, 0x54, 0xe6, 0x0, 0x8, 0xf4, 0x7,
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
    0xe0, 0x1f, 0xd0, 0x6, 0xf6, 0x0, 0x8f, 0x40,
    0xde, 0x0, 0x1, 0xfc, 0x5f, 0x70, 0x0, 0x8,
    0xfe, 0xf0, 0x0, 0x0, 0x1f, 0xf8, 0x0, 0x0,
    0x0, 0xcf, 0x10, 0x0, 0x0, 0x2f, 0x90, 0x0,
    0x2, 0x7d, 0xe1, 0x0, 0x0, 0x8f, 0xc3, 0x0,
    0x0, 0x0,

    /* U+007A "z" */
    0x6f, 0xff, 0xff, 0xf6, 0x16, 0x66, 0x8f, 0xf2,
    0x0, 0x0, 0xdf, 0x50, 0x0, 0xa, 0xf8, 0x0,
    0x0, 0x8f, 0xa0, 0x0, 0x5, 0xfc, 0x0, 0x0,
    0x2f, 0xf8, 0x66, 0x61, 0x6f, 0xff, 0xff, 0xf7,

    /* U+007B "{" */
    0x2, 0xbf, 0xd0, 0xc, 0xfc, 0x70, 0xf, 0xd0,
    0x0, 0x1f, 0xa0, 0x0, 0x1f, 0xa0, 0x0, 0x1f,
    0xa0, 0x0, 0x1f, 0xa0, 0x0, 0x1f, 0xa0, 0x0,
    0x1f, 0xa0, 0x0, 0x1f, 0xa0, 0x0, 0x1f, 0xa0,
    0x0, 0xf, 0xe2, 0x0, 0x9, 0xff, 0xd0, 0x0,
    0x58, 0x70,

    /* U+007C "|" */
    0xe, 0x21, 0xf3, 0x1f, 0x31, 0xf3, 0x1f, 0x31,
    0xf3, 0x1f, 0x31, 0xf3, 0x1f, 0x31, 0xf3, 0x1f,
    0x31, 0xf3, 0x1f, 0x30, 0x50,

    /* U+007D "}" */
    0x4f, 0xe7, 0x2, 0x9e, 0xf5, 0x0, 0x4f, 0x90,
    0x1, 0xfa, 0x0, 0x1f, 0xa0, 0x1, 0xfa, 0x0,
    0x1f, 0xa0, 0x1, 0xfa, 0x0, 0x1f, 0xa0, 0x1,
    0xfa, 0x0, 0x2f, 0xa0, 0x8, 0xf8, 0x4f, 0xff,
    0x22, 0x97, 0x20,

    /* U+007E "~" */
    0x0, 0x0, 0x0, 0x0, 0x0, 0x8, 0xef, 0xc6,
    0x25, 0xf1, 0x4f, 0x21, 0x7e, 0xff, 0x90, 0x2,
    0x0, 0x0, 0x21, 0x0
};

static const lv_font_dsc_t lts16_dsc[] = {
    {.bitmap_index = 0, .adv_w = 51, .box_w = 0, .box_h = 0, .ofs_x = 0, .ofs_y = 0},
    {.bitmap_index = 0, .adv_w = 52, .box_w = 3, .box_h = 11, .ofs_x = 0, .ofs_y = 0},
    {.bitmap_index = 17, .adv_w = 91, .box_w = 5, .box_h = 4, .ofs_x = 0, .ofs_y = 7},
    {.bitmap_index = 27, .adv_w = 151, .box_w = 10, .box_h = 11, .ofs_x = 0, .ofs_y = 0},
    {.bitmap_index = 82, .adv_w = 150, .box_w = 9, .box_h = 16, .ofs_x = 0, .ofs_y = -2},
    {.bitmap_index = 154, .adv_w = 211, .box_w = 13, .box_h = 11, .ofs_x = 0, .ofs_y = 0},
    {.bitmap_index = 226, .adv_w = 159, .box_w = 10, .box_h = 11, .ofs_x = 0, .ofs_y = 0},
    {.bitmap_index = 281, .adv_w = 49, .box_w = 3, .box_h = 4, .ofs_x = 0, .ofs_y = 7},
    {.bitmap_index = 287, .adv_w = 70, .box_w = 5, .box_h = 14, .ofs_x = 0, .ofs_y = -3},
    {.bitmap_index = 322, .adv_w = 70, .box_w = 5, .box_h = 14, .ofs_x = -1, .ofs_y = -3},
    {.bitmap_index = 357, .adv_w = 91, .box_w = 6, .box_h = 6, .ofs_x = 0, .ofs_y = 5},
    {.bitmap_index = 375, .adv_w = 129, .box_w = 8, .box_h = 7, .ofs_x = 0, .ofs_y = 2},
    {.bitmap_index = 403, .adv_w = 57, .box_w = 3, .box_h = 4, .ofs_x = 0, .ofs_y = -2},
    {.bitmap_index = 409, .adv_w = 105, .box_w = 7, .box_h = 3, .ofs_x = 0, .ofs_y = 3},
    {.bitmap_index = 420, .adv_w = 57, .box_w = 3, .box_h = 3, .ofs_x = 0, .ofs_y = 0},
    {.bitmap_index = 425, .adv_w = 108, .box_w = 7, .box_h = 14, .ofs_x = 0, .ofs_y = -3},
    {.bitmap_index = 474, .adv_w = 173, .box_w = 11, .box_h = 11, .ofs_x = 0, .ofs_y = 0},
    {.bitmap_index = 535, .adv_w = 77, .box_w = 5, .box_h = 11, .ofs_x = 0, .ofs_y = 0},
    {.bitmap_index = 563, .adv_w = 140, .box_w = 9, .box_h = 11, .ofs_x = 0, .ofs_y = 0},
    {.bitmap_index = 613, .adv_w = 141, .box_w = 9, .box_h = 11, .ofs_x = 0, .ofs_y = 0},
    {.bitmap_index = 663, .adv_w = 145, .box_w = 9, .box_h = 11, .ofs_x = 0, .ofs_y = 0},
    {.bitmap_index = 713, .adv_w = 144, .box_w = 9, .box_h = 11, .ofs_x = 0, .ofs_y = 0},
    {.bitmap_index = 763, .adv_w = 149, .box_w = 9, .box_h = 11, .ofs_x = 0, .ofs_y = 0},
    {.bitmap_index = 813, .adv_w = 142, .box_w = 9, .box_h = 11, .ofs_x = 0, .ofs_y = 0},
    {.bitmap_index = 863, .adv_w = 137, .box_w = 9, .box_h = 11, .ofs_x = 0, .ofs_y = 0},
    {.bitmap_index = 913, .adv_w = 150, .box_w = 9, .box_h = 11, .ofs_x = 0, .ofs_y = 0},
    {.bitmap_index = 963, .adv_w = 57, .box_w = 3, .box_h = 8, .ofs_x = 0, .ofs_y = 0},
    {.bitmap_index = 975, .adv_w = 57, .box_w = 3, .box_h = 11, .ofs_x = 0, .ofs_y = -3},
    {.bitmap_index = 992, .adv_w = 118, .box_w = 7, .box_h = 8, .ofs_x = 0, .ofs_y = 1},
    {.bitmap_index = 1020, .adv_w = 130, .box_w = 8, .box_h = 5, .ofs_x = 0, .ofs_y = 3},
    {.bitmap_index = 1040, .adv_w = 118, .box_w = 7, .box_h = 8, .ofs_x = 0, .ofs_y = 1},
    {.bitmap_index = 1068, .adv_w = 127, .box_w = 8, .box_h = 11, .ofs_x = 0, .ofs_y = 0},
    {.bitmap_index = 1112, .adv_w = 207, .box_w = 13, .box_h = 11, .ofs_x = 0, .ofs_y = 0},
    {.bitmap_index = 1184, .adv_w = 190, .box_w = 12, .box_h = 11, .ofs_x = 0, .ofs_y = 0},
    {.bitmap_index = 1250, .adv_w = 158, .box_w = 10, .box_h = 11, .ofs_x = 0, .ofs_y = 0},
    {.bitmap_index = 1305, .adv_w = 174, .box_w = 11, .box_h = 11, .ofs_x = 0, .ofs_y = 0},
    {.bitmap_index = 1366, .adv_w = 178, .box_w = 11, .box_h = 11, .ofs_x = 0, .ofs_y = 0},
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
    {.bitmap_index = 3569, .adv_w = 95, .box_w = 6, .box_h = 8, .ofs_x = 0, .ofs_y = 0},
    {.bitmap_index = 3593, .adv_w = 108, .box_w = 7, .box_h = 8, .ofs_x = 0, .ofs_y = 0},
    {.bitmap_index = 3621, .adv_w = 87, .box_w = 6, .box_h = 10, .ofs_x = 0, .ofs_y = 0},
    {.bitmap_index = 3651, .adv_w = 144, .box_w = 9, .box_h = 8, .ofs_x = 0, .ofs_y = 0},
    {.bitmap_index = 3687, .adv_w = 135, .box_w = 9, .box_h = 8, .ofs_x = 0, .ofs_y = 0},
    {.bitmap_index = 3723, .adv_w = 214, .box_w = 14, .box_h = 8, .ofs_x = 0, .ofs_y = 0},
    {.bitmap_index = 3779, .adv_w = 130, .box_w = 8, .box_h = 8, .ofs_x = 0, .ofs_y = 0},
    {.bitmap_index = 3811, .adv_w = 135, .box_w = 9, .box_h = 11, .ofs_x = 0, .ofs_y = -3},
    {.bitmap_index = 3861, .adv_w = 128, .box_w = 8, .box_h = 8, .ofs_x = 0, .ofs_y = 0},
    {.bitmap_index = 3893, .adv_w = 89, .box_w = 6, .box_h = 14, .ofs_x = 0, .ofs_y = -3},
    {.bitmap_index = 3935, .adv_w = 50, .box_w = 3, .box_h = 14, .ofs_x = 0, .ofs_y = -3},
    {.bitmap_index = 3956, .adv_w = 89, .box_w = 5, .box_h = 14, .ofs_x = 0, .ofs_y = -3},
    {.bitmap_index = 3991, .adv_w = 157, .box_w = 10, .box_h = 4, .ofs_x = 0, .ofs_y = 3}
};
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
