whowechina/aic_pico/firmware/src/upheaval.h

/*
 * Upheaval font by Ænigma
 * Downloaded from https://www.dafont.com/
 * Converted using https://lvgl.io/tools/fontconverter
 * Modificated for AIC Pico use
 */

#include <stdint.h>
#include "lvgl_font.h"

/*Store the image of the glyphs*/
static const uint8_t upheaval_bitmap[] = {
    /* U+0020 " " */
    0x0,

    /* U+0021 "!" */
    0xff, 0xff, 0xff, 0xf0, 0xff,

    /* U+0022 "\"" */
    0xef, 0xdc,

    /* U+0023 "#" */
    0x7b, 0xcf, 0x7b, 0xff, 0xff, 0xf7, 0xbc, 0xf7,
    0xbf, 0xff, 0xff, 0x7b, 0xcf, 0x78,

    /* U+0024 "$" */
    0xe, 0xf, 0xff, 0xff, 0xf8, 0xf, 0x1, 0xff,
    0x9f, 0xf8, 0xf, 0x1, 0xff, 0xff, 0xff, 0x7,
    0x0,

    /* U+0025 "%" */
    0x60, 0xff, 0x1f, 0xf3, 0xe6, 0x7c, 0xf, 0x81,
    0xf0, 0x3e, 0x67, 0xcf, 0xf8, 0xff, 0x6,

    /* U+0026 "&" */
    0xe, 0xf, 0xff, 0xff, 0xf8, 0xf, 0x1, 0xfc,
    0x3f, 0x87, 0x80, 0xf0, 0x1f, 0xfd, 0xff, 0x87,
    0x0,

    /* U+0027 "'" */
    0xfc,

    /* U+0028 "(" */
    0x7f, 0xff, 0xc7, 0x8f, 0x1e, 0x3c, 0x78, 0xfe,
    0xfc,

    /* U+0029 ")" */
    0xfd, 0xfc, 0x78, 0xf1, 0xe3, 0xc7, 0x8f, 0xff,
    0xf8,

    /* U+002A "*" */
    0x8, 0x6e, 0xff, 0xef, 0xe3, 0xe3, 0xb9, 0x8c,

    /* U+002B "+" */
    0xe, 0x1, 0xc3, 0xff, 0xff, 0xf0, 0xe0, 0x1c,
    0x0,

    /* U+002C "," */
    0xff, 0xf0,

    /* U+002D "-" */
    0xff, 0xff, 0xfc,

    /* U+002E "." */
    0xfc,

    /* U+002F "/" */
    0x0, 0xf0, 0x1f, 0x3, 0xe0, 0x7c, 0xf, 0x81,
    0xf0, 0x3e, 0x7, 0xc0, 0xf8, 0xf, 0x0,

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
    0xfc, 0x7f, 0x8f, 0xff, 0xef, 0xf8, 0x38, 0x7,
    0x0,

    /* U+0072 "r" */
    0xff, 0xdf, 0xff, 0xc7, 0xf8, 0xff, 0xfd, 0xff,
    0xbc, 0x7f, 0x8f, 0xf1, 0xfe, 0x3c,

    /* U+0073 "s" */
    0x7f, 0xff, 0xff, 0xc0, 0x78, 0xf, 0xfc, 0xff,
    0xc0, 0x78, 0xf, 0xff, 0xff, 0xf8,

    /* U+0074 "t" */
    0xff, 0xff, 0xf1, 0xe0, 0x78, 0x1e, 0x7, 0x81,
    0xe0, 0x78, 0x1e, 0x7, 0x80,

    /* U+0075 "u" */
    0xf1, 0xfe, 0x3f, 0xc7, 0xf8, 0xff, 0x1f, 0xe3,
    0xfc, 0x7f, 0x8f, 0xff, 0xef, 0xf8,

    /* U+0076 "v" */
    0xf1, 0xfe, 0x3f, 0xc7, 0xf8, 0xff, 0x1f, 0xe7,
    0xfd, 0xf7, 0xfc, 0xff, 0x1f, 0xc0,

    /* U+0077 "w" */
    0xf0, 0x7f, 0x83, 0xfc, 0x1f, 0xe4, 0xff, 0x77,
    0xff, 0xff, 0xff, 0xff, 0xbf, 0xf8, 0xff, 0x83,
    0xc0,

    /* U+0078 "x" */
    0xe0, 0xfe, 0x3f, 0xef, 0xbf, 0xe3, 0xf8, 0x7f,
    0x1f, 0xf7, 0xdf, 0xf1, 0xfc, 0x1c,

    /* U+0079 "y" */
    0xf0, 0xff, 0xf, 0xf0, 0xff, 0x9f, 0x7f, 0xe3,
    0xfc, 0xf, 0x0, 0xf0, 0xf, 0x0, 0xf0,

    /* U+007A "z" */
    0xff, 0xff, 0xfc, 0xf, 0x83, 0xe0, 0xf8, 0x3e,
    0xf, 0x83, 0xe0, 0xff, 0xff, 0xfc,

    /* U+007B "{" */
    0x3f, 0x7f, 0x78, 0x78, 0xf0, 0xf0, 0x78, 0x78,
    0x7f, 0x3f,

    /* U+007C "|" */
    0xff, 0xff, 0xff, 0xff, 0xff, 0xff,

    /* U+007D "}" */
    0xfc, 0xfe, 0x1e, 0x1e, 0xf, 0xf, 0x1e, 0x1e,
    0xfe, 0xfc,

    /* U+007E "~" */
    0x3e, 0x3d, 0xfc, 0xff, 0xfb, 0xfd, 0xff, 0xf3,
    0xfb, 0xc7, 0xc0,

    /* U+007F "" */
    0xff, 0xf3, 0xe7, 0x39, 0xf2, 0x7f, 0x1f, 0xe3,
    0xf9, 0x3e, 0x73, 0x9f, 0x3f, 0xfc
};

static const lv_font_dsc_t upheaval_dsc[] = {
    {.bitmap_index = 0, .adv_w = 112, .box_w = 1, .box_h = 1, .ofs_x = 0, .ofs_y = 0},
    {.bitmap_index = 1, .adv_w = 80, .box_w = 4, .box_h = 10, .ofs_x = 0, .ofs_y = 0},
    {.bitmap_index = 6, .adv_w = 128, .box_w = 7, .box_h = 2, .ofs_x = 0, .ofs_y = 8},
    {.bitmap_index = 8, .adv_w = 192, .box_w = 11, .box_h = 10, .ofs_x = 0, .ofs_y = 0},
    {.bitmap_index = 22, .adv_w = 192, .box_w = 11, .box_h = 12, .ofs_x = 0, .ofs_y = -1},
    {.bitmap_index = 39, .adv_w = 208, .box_w = 12, .box_h = 10, .ofs_x = 0, .ofs_y = 0},
    {.bitmap_index = 54, .adv_w = 192, .box_w = 11, .box_h = 12, .ofs_x = 0, .ofs_y = -1},
    {.bitmap_index = 71, .adv_w = 64, .box_w = 3, .box_h = 2, .ofs_x = 0, .ofs_y = 8},
    {.bitmap_index = 72, .adv_w = 128, .box_w = 7, .box_h = 10, .ofs_x = 0, .ofs_y = 0},
    {.bitmap_index = 81, .adv_w = 128, .box_w = 7, .box_h = 10, .ofs_x = 0, .ofs_y = 0},
    {.bitmap_index = 90, .adv_w = 160, .box_w = 9, .box_h = 7, .ofs_x = 0, .ofs_y = 3},
    {.bitmap_index = 98, .adv_w = 192, .box_w = 11, .box_h = 6, .ofs_x = 0, .ofs_y = 2},
    {.bitmap_index = 107, .adv_w = 64, .box_w = 3, .box_h = 4, .ofs_x = 0, .ofs_y = -2},
    {.bitmap_index = 109, .adv_w = 192, .box_w = 11, .box_h = 2, .ofs_x = 0, .ofs_y = 4},
    {.bitmap_index = 112, .adv_w = 64, .box_w = 3, .box_h = 2, .ofs_x = 0, .ofs_y = 0},
    {.bitmap_index = 113, .adv_w = 208, .box_w = 12, .box_h = 10, .ofs_x = 0, .ofs_y = 0},
    {.bitmap_index = 128, .adv_w = 192, .box_w = 11, .box_h = 10, .ofs_x = 0, .ofs_y = 0},
    {.bitmap_index = 142, .adv_w = 80, .box_w = 4, .box_h = 10, .ofs_x = 0, .ofs_y = 0},
    {.bitmap_index = 147, .adv_w = 192, .box_w = 11, .box_h = 10, .ofs_x = 0, .ofs_y = 0},
    {.bitmap_index = 161, .adv_w = 192, .box_w = 11, .box_h = 10, .ofs_x = 0, .ofs_y = 0},
    {.bitmap_index = 175, .adv_w = 192, .box_w = 11, .box_h = 10, .ofs_x = 0, .ofs_y = 0},
    {.bitmap_index = 189, .adv_w = 192, .box_w = 11, .box_h = 10, .ofs_x = 0, .ofs_y = 0},
    {.bitmap_index = 203, .adv_w = 192, .box_w = 11, .box_h = 10, .ofs_x = 0, .ofs_y = 0},
    {.bitmap_index = 217, .adv_w = 192, .box_w = 11, .box_h = 10, .ofs_x = 0, .ofs_y = 0},
    {.bitmap_index = 231, .adv_w = 192, .box_w = 11, .box_h = 10, .ofs_x = 0, .ofs_y = 0},
    {.bitmap_index = 245, .adv_w = 192, .box_w = 11, .box_h = 10, .ofs_x = 0, .ofs_y = 0},
    {.bitmap_index = 259, .adv_w = 64, .box_w = 3, .box_h = 10, .ofs_x = 0, .ofs_y = 0},
    {.bitmap_index = 263, .adv_w = 64, .box_w = 3, .box_h = 12, .ofs_x = 0, .ofs_y = -2},
    {.bitmap_index = 268, .adv_w = 144, .box_w = 8, .box_h = 10, .ofs_x = 0, .ofs_y = 0},
    {.bitmap_index = 278, .adv_w = 192, .box_w = 11, .box_h = 6, .ofs_x = 0, .ofs_y = 2},
    {.bitmap_index = 287, .adv_w = 144, .box_w = 8, .box_h = 10, .ofs_x = 0, .ofs_y = 0},
    {.bitmap_index = 297, .adv_w = 192, .box_w = 11, .box_h = 10, .ofs_x = 0, .ofs_y = 0},
    {.bitmap_index = 311, .adv_w = 224, .box_w = 13, .box_h = 10, .ofs_x = 0, .ofs_y = 0},
    {.bitmap_index = 328, .adv_w = 192, .box_w = 11, .box_h = 10, .ofs_x = 0, .ofs_y = 0},
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
    {.bitmap_index = 972, .adv_w = 192, .box_w = 11, .box_h = 12, .ofs_x = 0, .ofs_y = -2},
    {.bitmap_index = 989, .adv_w = 192, .box_w = 11, .box_h = 10, .ofs_x = 0, .ofs_y = 0},
    {.bitmap_index = 1003, .adv_w = 192, .box_w = 11, .box_h = 10, .ofs_x = 0, .ofs_y = 0},
    {.bitmap_index = 1017, .adv_w = 176, .box_w = 10, .box_h = 10, .ofs_x = 0, .ofs_y = 0},
    {.bitmap_index = 1030, .adv_w = 192, .box_w = 11, .box_h = 10, .ofs_x = 0, .ofs_y = 0},
    {.bitmap_index = 1044, .adv_w = 192, .box_w = 11, .box_h = 10, .ofs_x = 0, .ofs_y = 0},
    {.bitmap_index = 1058, .adv_w = 224, .box_w = 13, .box_h = 10, .ofs_x = 0, .ofs_y = 0},
    {.bitmap_index = 1075, .adv_w = 192, .box_w = 11, .box_h = 10, .ofs_x = 0, .ofs_y = 0},
    {.bitmap_index = 1089, .adv_w = 208, .box_w = 12, .box_h = 10, .ofs_x = 0, .ofs_y = 0},
    {.bitmap_index = 1104, .adv_w = 192, .box_w = 11, .box_h = 10, .ofs_x = 0, .ofs_y = 0},
    {.bitmap_index = 1118, .adv_w = 144, .box_w = 8, .box_h = 10, .ofs_x = 0, .ofs_y = 0},
    {.bitmap_index = 1128, .adv_w = 80, .box_w = 4, .box_h = 12, .ofs_x = 0, .ofs_y = -1},
    {.bitmap_index = 1134, .adv_w = 144, .box_w = 8, .box_h = 10, .ofs_x = 0, .ofs_y = 0},
    {.bitmap_index = 1144, .adv_w = 240, .box_w = 14, .box_h = 6, .ofs_x = 0, .ofs_y = 2},
    {.bitmap_index = 1155, .adv_w = 192, .box_w = 11, .box_h = 10, .ofs_x = 0, .ofs_y = 0}
};

static const lv_font_t lv_upheaval = {
    .range_start = 32,
    .range_length = 96,
    .bit_per_pixel = 1,
    .line_height = 14,
    .base_line = 3,
    .dsc = upheaval_dsc,
    .bitmap = upheaval_bitmap,
};
