whowechina/aic_pico/firmware/src/aime.c

/*
 * AIME Reader
 * WHowe <github.com/whowechina>
 * 
 * Use NFC Module to read AIME
 */

#include <stdint.h>
#include <stdbool.h>

#include "bsp/board.h"
#include "hardware/gpio.h"
#include "hardware/i2c.h"

#include "config.h"
#include "nfc.h"
#include "aime.h"

#define AIME_EXPIRE_TIME 5000000ULL
enum {
    CMD_GET_FW_VERSION = 0x30,
    CMD_GET_HW_VERSION = 0x32,

    // Card read
    CMD_START_POLLING = 0x40,
    CMD_STOP_POLLING = 0x41,
    CMD_CARD_DETECT = 0x42,
    CMD_CARD_SELECT = 0x43,
    CMD_CARD_HALT = 0x44,

    // MIFARE
    CMD_MIFARE_KEY_SET_A = 0x50,
    CMD_MIFARE_AUTHORIZE_A = 0x51,
    CMD_MIFARE_READ = 0x52,
    CMD_MIFARE_WRITE = 0x53,
    CMD_MIFARE_KEY_SET_B = 0x54,
    CMD_MIFARE_AUTHORIZE_B = 0x55,

    // Boot,update
    CMD_TO_UPDATER_MODE = 0x60,
    CMD_SEND_HEX_DATA = 0x61,
    CMD_TO_NORMAL_MODE = 0x62,
    CMD_SEND_BINDATA_INIT = 0x63,
    CMD_SEND_BINDATA_EXEC = 0x64,

    // FeliCa
    CMD_FELICA_PUSH = 0x70,
    CMD_FELICA_OP = 0x71,

    // LED board
    CMD_EXT_BOARD_LED_RGB = 0x81,
    CMD_EXT_BOARD_INFO = 0xf0,
    CMD_EXT_TO_NORMAL_MODE = 0xf5,
};

enum {
    STATUS_OK = 0,
    STATUS_INVALID_COMMAND = 3,
};

const char *fw_version[] = { "TN32MSEC003S F/W Ver1.0", "\x94" };
const char *hw_version[] = { "TN32MSEC003S H/W Ver3.0", "837-15396" };
const char *led_info[] = { "15084\xFF\x10\x00\x12", "000-00000\xFF\x11\x40" };
static int baudrate_mode = 0;

static struct {
    bool active; // currently active
    uint8_t idm[8];
    const uint8_t pmm[8];
    const uint8_t syscode[2];
} virtual_aic = { false, "", "\x00\xf1\x00\x00\x00\x01\x43\x00", "\x88\xb4" };

static void putc_trap(uint8_t byte)
{
}

static aime_putc_func aime_putc = putc_trap;

void aime_set_baudrate(int mode)
{
    baudrate_mode = (mode == 0) ? 0 : 1;
}

void aime_init(aime_putc_func putc_func)
{
    aime_putc = putc_func;
}

static uint8_t mifare_keys[2][6]; // 'KeyA' and 'KeyB'

static union __attribute__((packed)) {
    struct {
        uint8_t len;
        uint8_t addr;
        uint8_t seq;
        uint8_t cmd;
        uint8_t status;
        uint8_t payload_len;
        uint8_t payload[];
    };
    uint8_t raw[256];
} response;

static union __attribute__((packed)) {
    struct {
        uint8_t len;
        uint8_t addr;
        uint8_t seq;
        uint8_t cmd;
        uint8_t payload_len;
        union {
            struct {
                uint8_t uid[4];
                uint8_t block_id;
            } mifare;
            struct {
                uint8_t idm[8];
                uint8_t len;
                uint8_t code;
                uint8_t data[0];
            } felica;
            uint8_t payload[250];
        };
    };
    uint8_t raw[256];
} request;

struct {
    bool active;
    uint8_t len;
    uint8_t check_sum;
    bool escaping;
    uint64_t time;
} req_ctx;

static void build_response(int payload_len)
{
    response.len = payload_len + 6;
    response.addr = request.addr;
    response.seq = request.seq;
    response.cmd = request.cmd;
    response.status = STATUS_OK;
    response.payload_len = payload_len;
}

static void send_response()
{
    uint8_t checksum = 0;
    uint8_t sync = 0xe0;
    aime_putc(sync);

    for (int i = 0; i < response.len; i++) {
        uint8_t c = response.raw[i];
        checksum += c;
        if (c == 0xe0 || c == 0xd0) {
            uint8_t escape = 0xd0;
            aime_putc(escape);
            c--;
        }
        aime_putc(c);
    }

    aime_putc(checksum);
}

static void send_simple_response(uint8_t status)
{
    build_response(0);
    response.status = status;
    send_response();
}

static void cmd_to_normal_mode()
{
    send_simple_response(STATUS_INVALID_COMMAND);
}

static void cmd_fake_version(const char *version[])
{
    int len = strlen(version[baudrate_mode]);
    build_response(len);
    memcpy(response.payload, version[baudrate_mode], len);
    send_response();
}

static void cmd_key_set(uint8_t key[6])
{
    memcpy(key, request.payload, 6);
    send_simple_response(STATUS_OK);
}

static void cmd_set_polling(bool enabled)
{
    nfc_rf_field(enabled);
    send_simple_response(STATUS_OK);
}

typedef struct __attribute__((packed)) {
    uint8_t count;
    uint8_t type;
    uint8_t id_len;
    union {
        struct {
            uint8_t idm[8];
            uint8_t pmm[8];
        };
        uint8_t uid[6];
    };
} card_info_t;

static void handle_mifare_card(const uint8_t *uid, int len)
{
    card_info_t *card = (card_info_t *) response.payload;

    build_response(len > 4 ? 10 : 7);

    card->count = 1;
    card->type = 0x10;
    card->id_len = len;
    memcpy(card->uid, uid, len);

    printf("\nMIFARE Card:");
    for (int i = 0; i < len; i++) {
        printf(" %02x", uid[i]);
    }
}

static void handle_felica_card(const uint8_t idm[8], const uint8_t pmm[8])
{
    build_response(19);
    card_info_t *card = (card_info_t *) response.payload;

    card->count = 1;
    card->type = 0x20;
    card->id_len = 16;
    memcpy(card->idm, idm, 8);
    memcpy(card->pmm, pmm, 8);
}

static void fake_felica_card()
{
    build_response(19);
    card_info_t *card = (card_info_t *) response.payload;

    card->count = 1;
    card->type = 0x20;
    card->id_len = 16;
    memcpy(card->idm, virtual_aic.idm, 8);
    memcpy(card->pmm, virtual_aic.pmm, 8);
}

static void handle_no_card()
{
    build_response(1);
    card_info_t *card = (card_info_t *) response.payload;

    card->count = 0;
    response.status = STATUS_OK;
}

static void cmd_detect_card()
{
    nfc_card_t card = nfc_detect_card();
    display_card(&card);

    switch (card.card_type) {
        case NFC_CARD_MIFARE:
            if (aic_cfg->virtual_aic) {
                printf("\nVirtual FeliCa from MIFARE.");
                virtual_aic.active = true;
                memcpy(virtual_aic.idm, "\x01\x01", 2);
                if (card.len == 4) {
                    memcpy(virtual_aic.idm + 2, card.uid, 4);
                    memcpy(virtual_aic.idm + 6, card.uid, 2);
                } else if (card.len == 7) {
                    memcpy(virtual_aic.idm + 2, card.uid, 6);
                }
                fake_felica_card();
            } else {
                handle_mifare_card(card.uid, card.len);
            }
            break;
        case NFC_CARD_FELICA:
            if (aic_cfg->virtual_aic) {
                printf("\nVirtual FeliCa from FeliCa.");
                virtual_aic.active = true;
                memcpy(virtual_aic.idm, card.uid, 8);
                fake_felica_card();
            } else {
                handle_felica_card(card.uid, card.pmm);
            }
            break;
        case NFC_CARD_VICINITY:
            if (aic_cfg->virtual_aic) {
                printf("\nVirtual FeliCa from 15693.");
                virtual_aic.active = true;
                memcpy(virtual_aic.idm, card.uid, 8);
                virtual_aic.idm[0] = 0x01;
                fake_felica_card();
            }
            break;
        default:
            handle_no_card();
            break;
    }

    send_response();
}

static void cmd_card_select()
{
    send_simple_response(STATUS_OK);
}

static void cmd_mifare_auth(int type)
{
    const uint8_t *key = mifare_keys[type];
    nfc_mifare_auth(request.mifare.uid, request.mifare.block_id,
                    type, key);
    send_simple_response(STATUS_OK);
}

static void cmd_mifare_read()
{
    build_response(16);
    memset(response.payload, 0, 16);
    nfc_mifare_read(request.mifare.block_id, response.payload);
    send_response();
}

static void cmd_mifare_halt()
{
    send_simple_response(STATUS_OK);
}

static void cmd_felica()
{
    send_simple_response(STATUS_INVALID_COMMAND);
    return;
}

static uint32_t led_color;

static void cmd_led_rgb()
{
    led_color = request.payload[0] << 16 | request.payload[1] << 8 | request.payload[2];
    build_response(0);
    send_response();
}

static void aime_handle_frame()
{
    switch (request.cmd) {
        case CMD_TO_NORMAL_MODE:
            cmd_to_normal_mode();
            break;
        case CMD_GET_FW_VERSION:
            cmd_fake_version(fw_version);
            break;
        case CMD_GET_HW_VERSION:
            cmd_fake_version(hw_version);
            break;
        case CMD_MIFARE_KEY_SET_A:
            cmd_key_set(mifare_keys[0]);
            break;
        case CMD_MIFARE_KEY_SET_B:
            cmd_key_set(mifare_keys[1]);
            break;

        case CMD_START_POLLING:
            cmd_set_polling(true);
            break;
        case CMD_STOP_POLLING:
            cmd_set_polling(false);
            break;
        case CMD_CARD_DETECT:
            cmd_detect_card();
            break;

        case CMD_FELICA_PUSH:
        case CMD_FELICA_OP:
            cmd_felica();
            break;

        case CMD_CARD_SELECT:
            cmd_card_select();
            break;
        
        case CMD_MIFARE_AUTHORIZE_A:
            cmd_mifare_auth(0);
            break;

        case CMD_MIFARE_AUTHORIZE_B:
            cmd_mifare_auth(1);
            break;
        
        case CMD_MIFARE_READ:
            cmd_mifare_read();
            break;

        case CMD_CARD_HALT:
            cmd_mifare_halt();
            break;

        case CMD_EXT_BOARD_INFO:
            cmd_fake_version(led_info);
            break;
        case CMD_EXT_BOARD_LED_RGB:
            cmd_led_rgb();
            break;

        case CMD_SEND_HEX_DATA:
        case CMD_EXT_TO_NORMAL_MODE:
            send_simple_response(STATUS_OK);
            break;

        default:
            printf("\nUnknown command: %02x [", request.cmd);
            for (int i = 0; i < request.len; i++) {
                printf(" %02x", request.raw[i]);
            }
            printf("]");
            send_simple_response(STATUS_OK);
            break;
    }
}

static uint64_t expire_time;

bool aime_feed(int c)
{
    if (c == 0xe0) {
        req_ctx.active = true;
        req_ctx.len = 0;
        req_ctx.check_sum = 0;
        req_ctx.escaping = false;
        req_ctx.time = time_us_64();
        return true;
    }

    if (!req_ctx.active) {
        return false;
    }

    if (c == 0xd0) {
        req_ctx.escaping = true;
        return true;
    }

    if (req_ctx.escaping) {
        c++;
        req_ctx.escaping = false;
    }

    if (req_ctx.len != 0 && req_ctx.len == request.len) {
        if (req_ctx.check_sum == c) {
            aime_handle_frame();
            req_ctx.active = false;
            expire_time = time_us_64() + AIME_EXPIRE_TIME;
        }
        return true;
    }

    request.raw[req_ctx.len] = c;
    req_ctx.len++;
    req_ctx.check_sum += c;

    return true;
}

uint64_t aime_expire_time()
{
    return expire_time;
}

uint32_t aime_led_color()
{
    return led_color;
}
