whowechina/aic_pico/firmware/src/config.h

/*
 * Controller Config
 * WHowe <github.com/whowechina>
 */

#ifndef CONFIG_H
#define CONFIG_H

#include <stdint.h>
#include <stdbool.h>

#include <mode.h>

typedef struct __attribute__((packed)) {
    struct {
        uint8_t level_idle;
        uint8_t level_active;
        uint8_t rgb_en:1;
        uint8_t rgb_order:3;
        uint8_t rgb_reserved:4;
        bool led;
    } light;
    struct {
        bool virtual_aic;
        uint8_t mode;
    } reader;
    struct {
        uint8_t backlight;
        uint8_t orientation; // 0: auto, 1: up, 2: down
    } lcd;
    struct {
        uint8_t reserved[4];
    } tweak;
    uint8_t padding[3];
    struct {
        struct {
            uint8_t uidlen;
            uint8_t swipe : 1;
            uint8_t delay : 7;
            uint8_t uid[8];
            char pin[16];
        } entries[4];
        bool enabled;
        uint8_t reserved[3];
    } autopin;
    uint32_t reserved;
} aic_cfg_t;

typedef volatile struct {
    bool debug;
    bool touch;
    reader_mode_t mode;
} aic_runtime_t;

extern aic_cfg_t *aic_cfg;
extern aic_runtime_t aic_runtime;

void config_init();
void config_changed(); // Notify the config has changed
void config_factory_reset(); // Reset the config to factory default

#endif
