whowechina/aic_pico/firmware/src/gui.h

/*
 * GUI on a Touch Display (ST7789 + CST816)
 * WHowe <github.com/whowechina>
 * 
 */

#ifndef GUI_H
#define GUI_H

#include <stdint.h>
#include <stdbool.h>

#include "nfc.h"

void gui_init();
void gui_level(uint8_t level);
void gui_loop();
uint16_t gui_keypad_read();
void gui_report_card_name(nfc_card_name card);
void gui_report_card_id(const uint8_t *id, int len, bool virtual, nfc_card_type type);

#endif
