whowechina/aic_pico/(commit log)

2023-11-04 LED and stuff working
2023-11-05 Production files upload
    [aic_pico_bottom.stl, aic_pico_top.stl, aic_pico_top_with_logo.3mf]
2023-11-07 PCB for AIC Key starts
    [Credit Button Assy (Groovy).step, EVQ-P1D05M.stp, J 2835.step, SKPMAM.STEP, Tact Switch 4.5mm SMT.step, User Library-PTS645SL95SMTR92-LFS.STEP, User Library-WS2812-2020.step, User Library-WS2812-4020.step]
2023-11-07 PCB Button reference added
    [aic_pico.kicad_pcb]
2023-11-08 PCB Button and LED layout done
    [SKRRABE010.stp, SKSTAAE010.stp, User Library-RGB1204.STEP, aic_pico.kicad_pcb, aic_pico.kicad_sch]
2023-11-08 Button and RGB routed
    [aic_pico.kicad_pcb, aic_pico.kicad_sch]
2023-11-09 Optional LEDs routed
    [aic_pico.kicad_pcb, aic_pico.kicad_sch]
2023-11-10 AIC Key PCB v1.0 done
    [aic_pico.kicad_pcb, aic_pico.kicad_sch, pn5180.step]
2023-11-11 PCB dir structure update
    [aic_pico_pn5180.kicad_pcb, aic_pico_pn5180.kicad_sch]
2023-11-11 AIC Key PN5180 PCB v1.0
    [aic_key_pn532.kicad_pcb, aic_key_pn532.kicad_sch]
2023-11-11 README and ready for publish
    [aic_pico_bottom.stl, aic_pico_top_ams.3mf, aic_pico_top_tall.stl, aic_pico_top_tall_ams.3mf, aic_pico_top_with_logo.3mf]
2023-11-12 Update wiring diagram and PN532 I2C mode
2023-11-12 LED pin to GP12
2023-11-12 LED too bright solution.
2023-11-15 Light support both RGB and regular LED
2023-11-18 Better LED control
2023-11-18 Enable IO lock to avoid deadlock
    [light.c, main.c]
2023-11-18 AIC Key ready
    [aic_key_bottom.stl, aic_key_top.stl, aic_key_top_ams.3mf]
2023-11-18 PCB part added
2023-11-18 PCB v1.1, pad optimization
    [aic_key_pn532.kicad_pcb, aic_pico_pn5180.kicad_pcb]
2023-11-18 Panasonic switch option added
    [aic_key_top_tall.stl, aic_key_top_tall_ams.3mf]
2023-11-28 Feli and mifare and reset works
    [commands.c]
2023-12-01 Fritzing files for AIC Pico (PN532 and PN5180)
    [aic_pico_pn5180.fzz, aic_pico_pn532.fzz]
2023-12-03 Readme and wiring diagram update
    [aic_pico_pn5180.fzz, aic_pico_pn532.fzz]
2023-12-10 WS2812C-2020 option for AIC Key PN532
    [aic_key_pn532.kicad_pcb, aic_key_pn532.kicad_sch]
2024-01-14 Fix amiibo not working on PN5180 and refactoring of cardio
    [main.c, nfc.c, nfc.h, pn532.c, pn532.h]
2024-01-14 PN5180 major bug fixed
    [aime.c, nfc.c, nfc.h]
2024-01-20 fix 15693 byte order
    [main.c]
2024-01-21 Fix card id display issue
    [main.c]
2024-02-15 Fix wiring diagram typo
2024-02-25 Support up to 64 RGB LEDs
2024-02-25 Add USB protection in housing
    [aic_key_bottom.stl, aic_key_top.stl, aic_key_top_ams.3mf, aic_key_top_surface.stl, aic_key_top_surface_ams.3mf, aic_key_top_tact.stl, aic_key_top_tact_ams.3mf, aic_key_top_tall.stl]
2024-02-25 Easier language switch
2024-03-16 Fix a parameter order issue
    [nfc.h]
2024-03-16 Attach I2C interface to skip init
    [main.c, nfc.h]
2024-03-16 Update Readme as AIC Pico Lib is ready
2024-03-23 Optimize LED 1204 footprint
    [aic_key_pn532.kicad_pcb, aic_pico_pn5180.kicad_pcb]
2024-03-24 AIC Key top part with no keyholes
    [aic_key_top_nokey.stl, aic_key_top_nokey_ams.3mf]
2024-04-04 Fix some typo
    [aic_key_pn532.kicad_pcb, aic_pico_pn5180.kicad_pcb]
2024-04-21 Light follows aime or bana led commands
2024-04-29 Fix incorrect light effect in bana i/o
    [main.c]
2024-05-12 Lighting cleanup and fix HID light color
    [light.c, light.h, main.c]
2024-05-13 AIC Touch in progress
    [aic_touch.kicad_pcb, aic_touch.kicad_sch]
2024-05-13 AIC Touch PCB v1.0
    [aic_touch.kicad_pcb]
2024-05-14 Display and touch driver
2024-05-15 Optimize display and touch driver
2024-05-16 Fix PCB issue and change to 4020 RGB
    [aic_touch.kicad_pcb, aic_touch.kicad_sch]
2024-05-18 More current to drive regular LED
2024-05-19 st7789 vram dma operations
2024-05-19 Fix missing KEYPAD_EN pin
    [board_defs.h]
2024-05-22 Power filtering for PN5180 on AIC touch
    [aic_touch.kicad_pcb, aic_touch.kicad_sch]
2024-05-22 Power filtering for PN5180 on AIC Key
    [aic_pico_pn5180.kicad_pcb, aic_pico_pn5180.kicad_sch]
2024-05-22 Readme update for power filter for PN5180
2024-05-23 L1 to 1206 and power from VBUS
    [aic_pico_pn5180.kicad_pcb, aic_pico_pn5180.kicad_sch, aic_touch.kicad_pcb, aic_touch.kicad_sch]
2024-05-23 Overclock SPI to 75MHz
2024-05-25 Hybrid AIC Key PCB and AIC touch RGB back to 1204
    [aic_key.kicad_pcb, aic_key.kicad_sch, aic_key_pn532.kicad_pcb, aic_key_pn532.kicad_sch, aic_touch.kicad_pcb, aic_touch.kicad_sch]
2024-05-25 Update readme according to latest PCB change
2024-05-26 Fix major bug in reader buffer handling
    [main.c]
2024-05-27 Dirty response to "commthru" cmd and some minor fix
    [nfc.h]
2024-05-30 Fix font conthrax "." offset
    [conthrax.h]
2024-06-01 Touch PCB v1.4 (may improve RF)
    [aic_touch.kicad_pcb, aic_touch.kicad_sch]
2024-06-02 Don't break rgb pio by gpio interrupt
2024-06-02 Move touch lcd init to core1 for its interrupt handling
2024-06-02 Interrupt driven and begin gesture part
2024-06-03 Document for AIC touch
    [aic_touch_bottom.stl, aic_touch_top.3mf, aic_touch_top.stl]
2024-06-05 Offload PN532 antenna for better signal
    [aic_touch.kicad_pcb, aic_touch.kicad_sch]
2024-06-05 Readme for new antenna mods
2024-06-09 Button pressing effect
2024-06-10 DMA driven RGB led
2024-06-10 Fix regular LED brightness
    [light.c]
2024-06-11 Filter out false card ids from faulty module
2024-06-11 Move the false card id filtering into PN5180 module
2024-06-14 Overclock to 160MHz (80MHz spi)
2024-06-16 RGB565 implemented as RGB555 (remove buggy 1 bit from Green)
    [st7789.h]
2024-06-18 Minor reader line timeout fix
    [main.c]
2024-06-18 Minor gui loop change fix
    [gui.c, st7789.c, st7789.h]
2024-06-18 Remove debug print
2024-07-15 Cross-reference to new Groove Pico
2024-10-22 Bambu AMS project for touch top
    [aic_touch_top_ams.3mf]
2024-12-02 Fix getchar return handling
    [cli.c]
2025-01-08 Move some print to debug mode
2025-01-11 Fix Touch card ID display
    [gui.c, main.c]
2025-01-14 Touch PCB v1.51, optimize footprints
    [aic_touch.kicad_pcb, aic_touch.kicad_sch]
2025-02-22 Auto PIN-entry feature
2025-02-23 Minor CLI message fix
    [commands.c]
2025-02-24 Fix autopin add command
    [cardio.c, commands.c]
2025-02-25 Fix autopin card timeout logic
    [cardio.c]
2025-03-15 Alternative I2C ports for PN532
2025-03-17 Fix issue with repetitive character in PIN (auto-pin)
    [cardio.c, main.c]
2025-08-21 Fix PN5180 freeze on some pico clones
2026-03-23 Pico led off
2026-03-24 ST7789 auto spi clock
2026-04-01 Fix missing change for "remove soft crop"
    [gui.c]
2026-04-01 Fix save.c alloc bug (unreachable in practice)
    [save.c]
2026-04-01 Fix gui text buffer overflow
    [gui.c]
2026-04-01 Add Pico 2 support
2026-04-10 Accelerometer support
2026-04-10 Improve the accelerometer feature
2026-08-25 AIC Key PCB v1.51 (minor finetune)
    [aic_key.kicad_pcb, aic_key.kicad_sch]
